jobitjoseph/Acestat-Wireless/aducm_board1.png

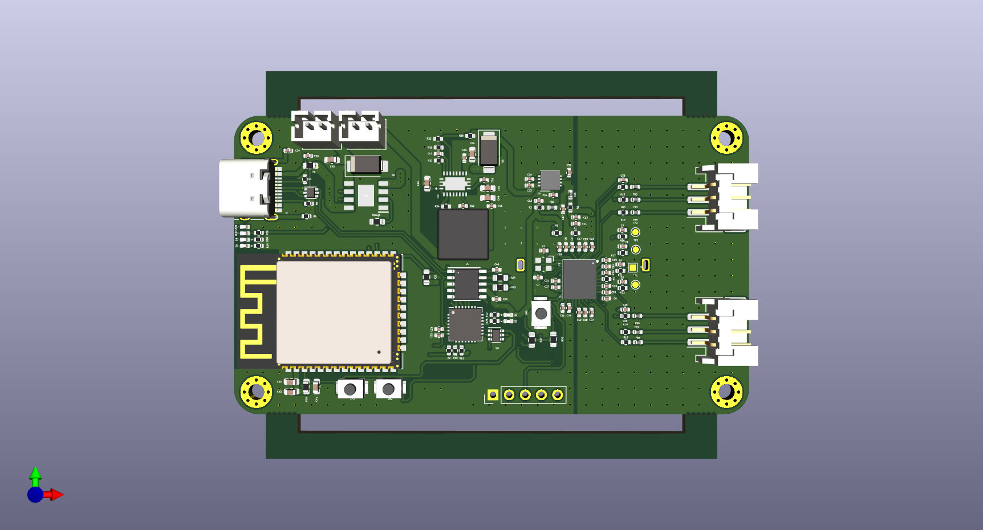
aducm_board1.png
