jobitjoseph/Acestat-Wireless/aducm_board2.png

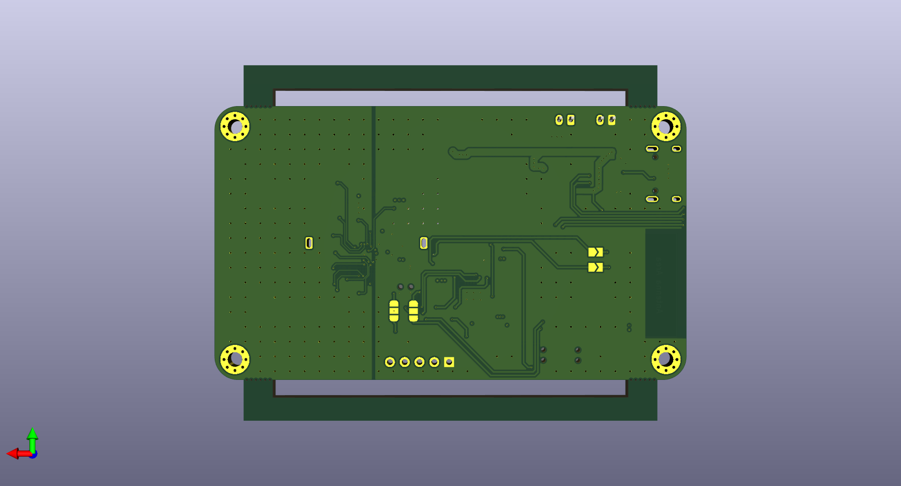
aducm_board2.png
