jobitjoseph/Acestat-Wireless/Bottom.jpg

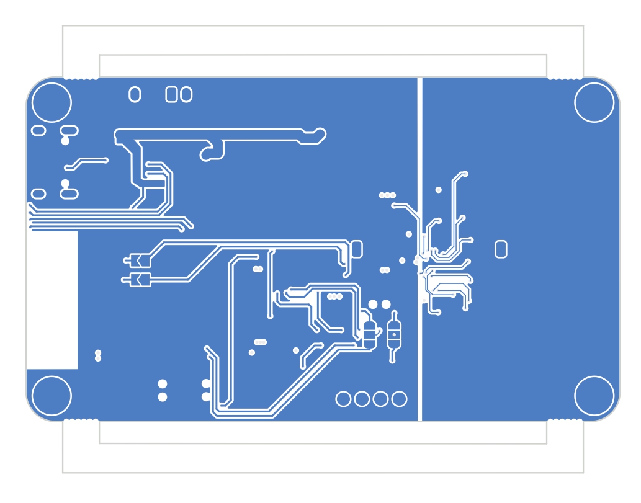
Bottom.jpg
