jobitjoseph/Acestat-Wireless/In1.jpg

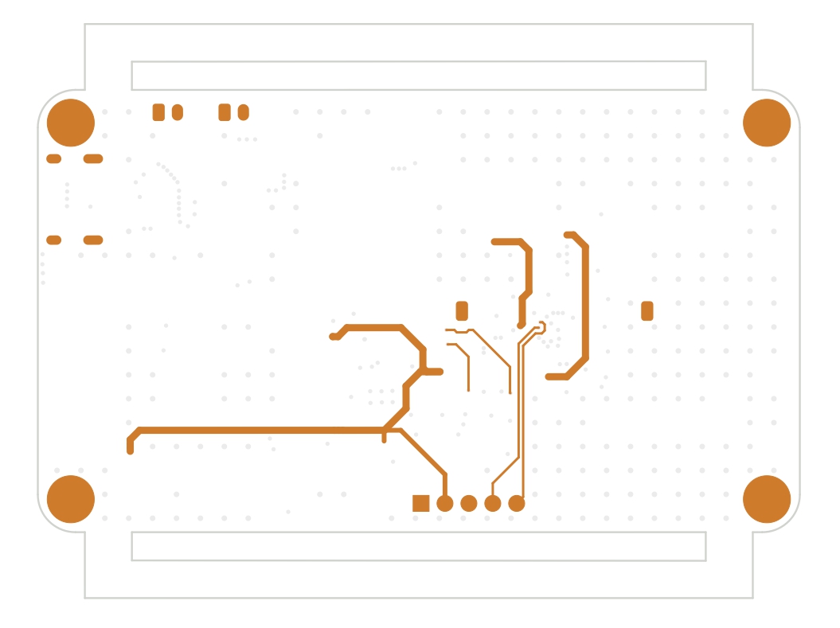
In1.jpg
