jobitjoseph/Acestat-Wireless/In2.jpg

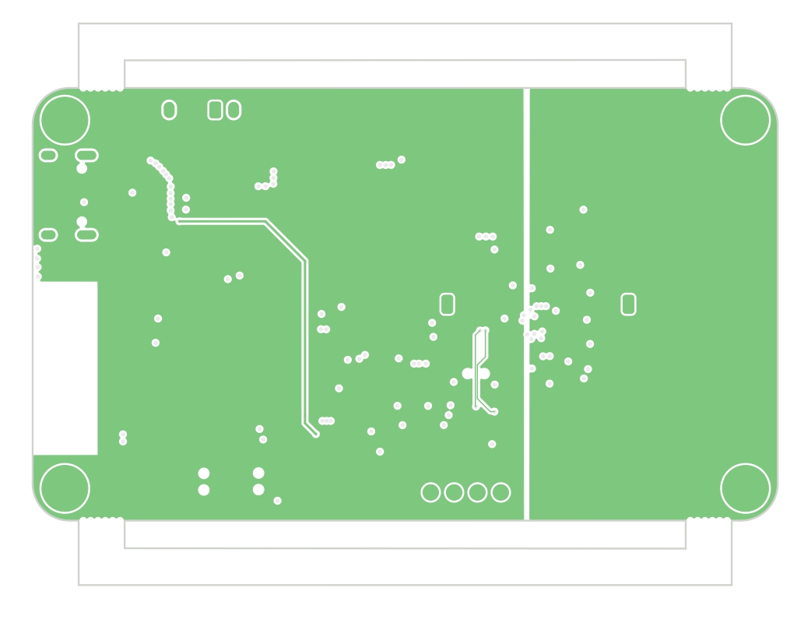
In2.jpg
