jobitjoseph/Acestat-Wireless/Top.jpg

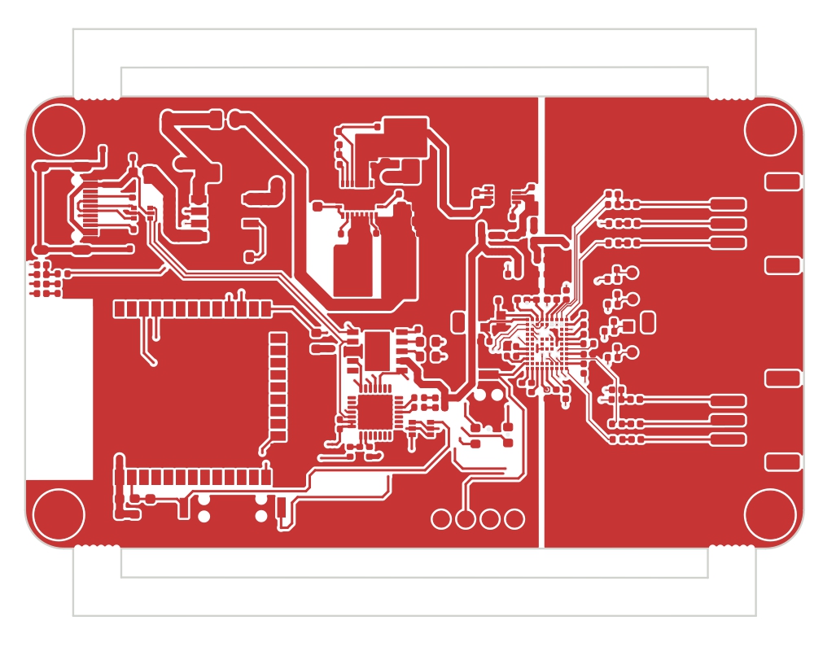
Top.jpg
