jobitjoseph/Acestat-Wireless/aducm_board.pdf

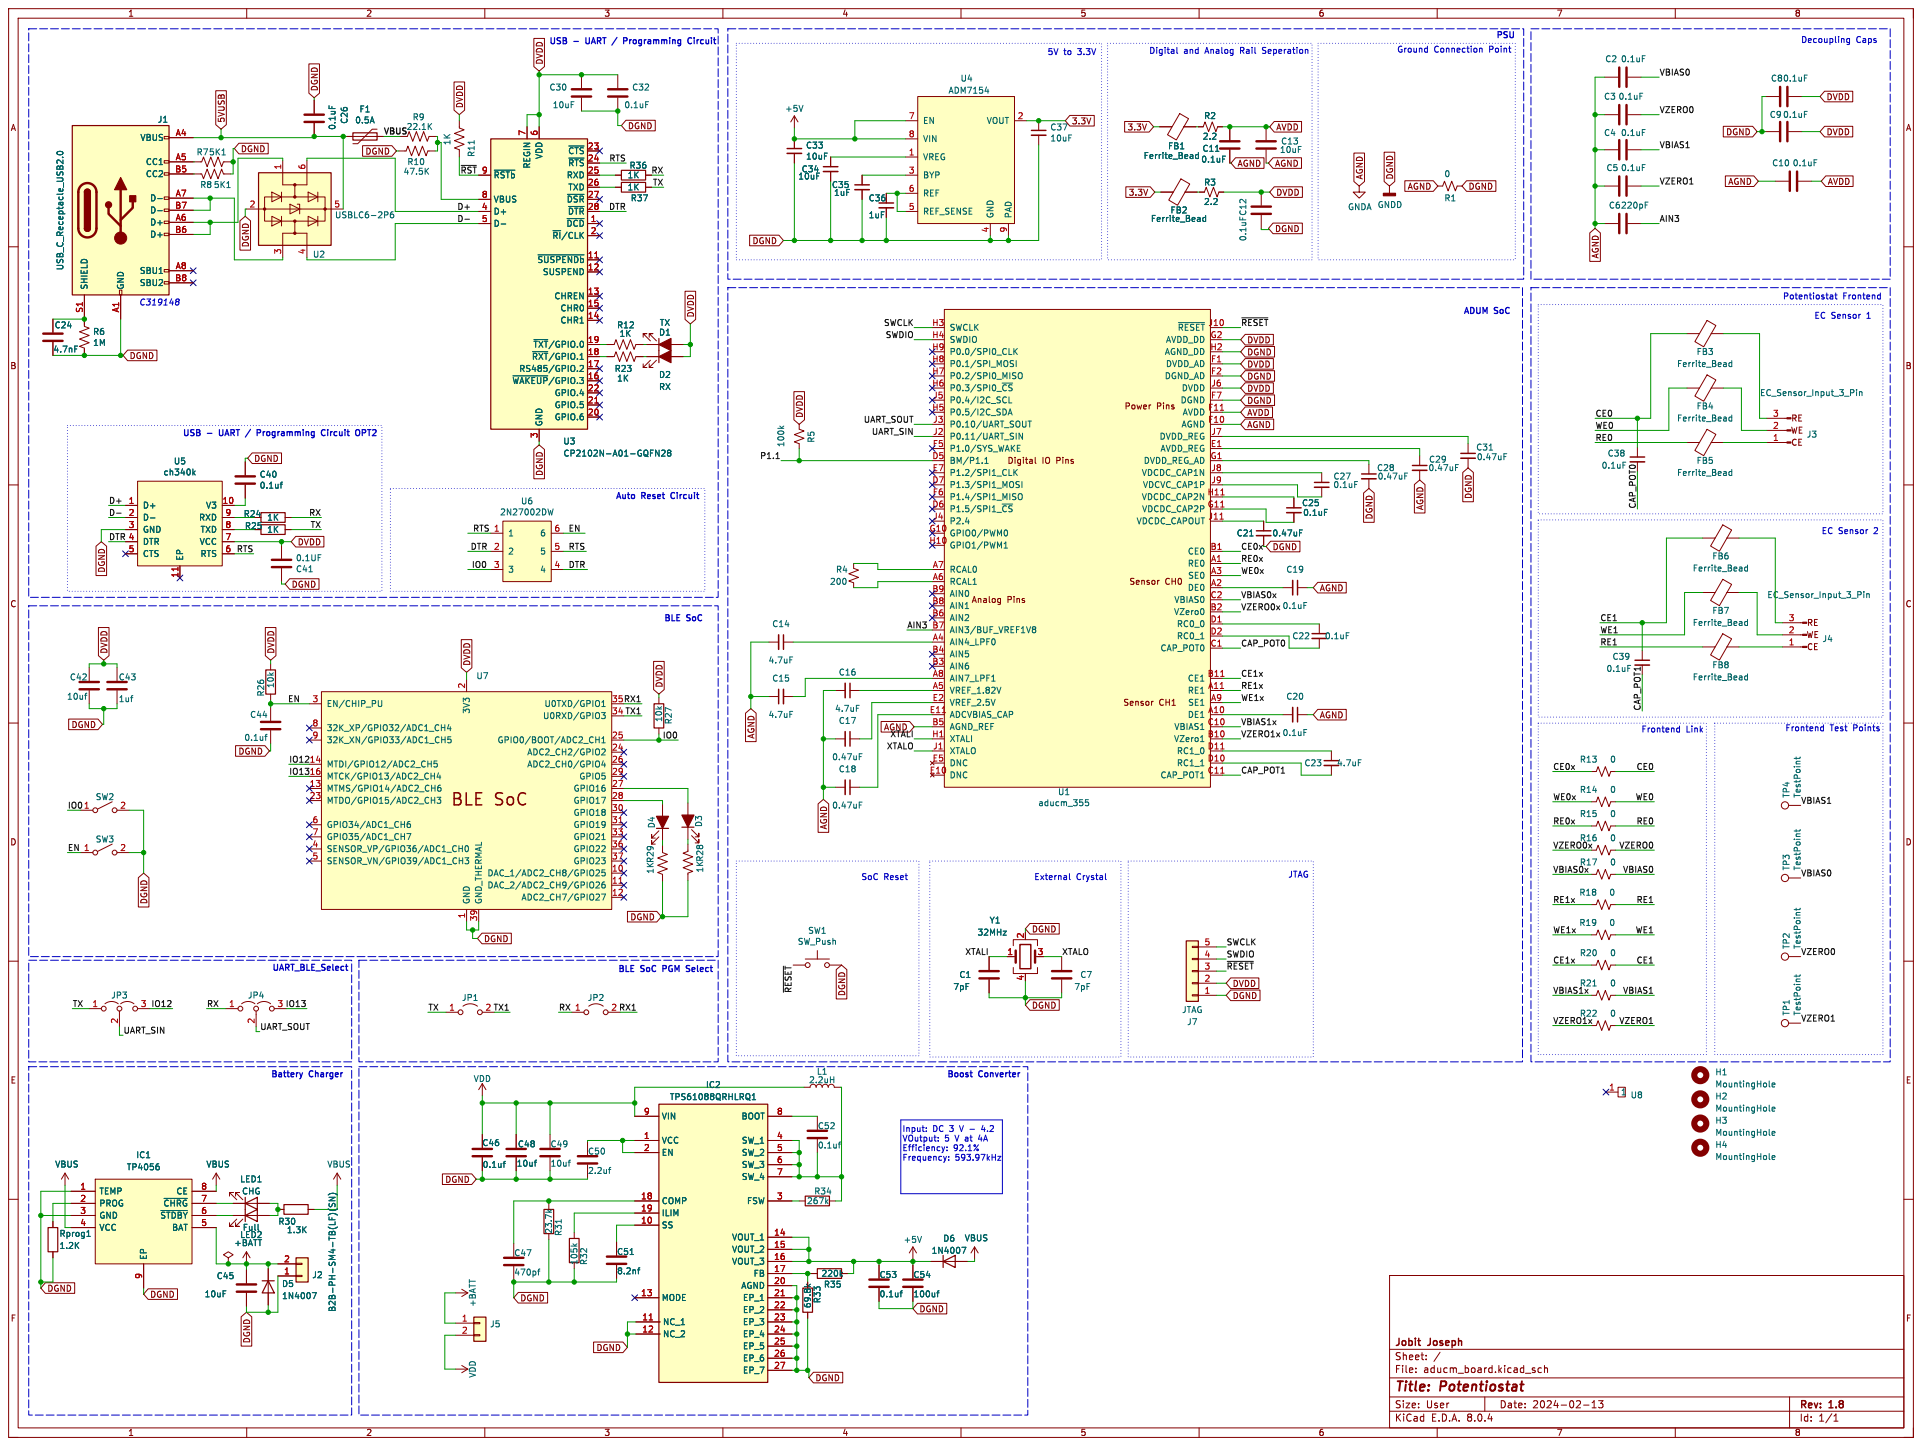
[picture p7: page 1]

4 REF_SENSE 5 REF 6 EN 7 VIN 8 PAD

Id: 1/1 Title: Potentiostat File: aducm_board.kicad_sch Sheet: / Jobit Joseph 23.7k R31 C41

H2 MountingHole H1 MountingHole H4 MountingHole H3 MountingHole

Input: DC 3 V - 4.2 VOutput: 5 V at 4A
