jobitjoseph/Acestat-Wireless/PCB/aducm_board/aducm_board.kicad_pcb

## KiCad design PCB/aducm_board/aducm_board.kicad_pcb (2024-11-03)

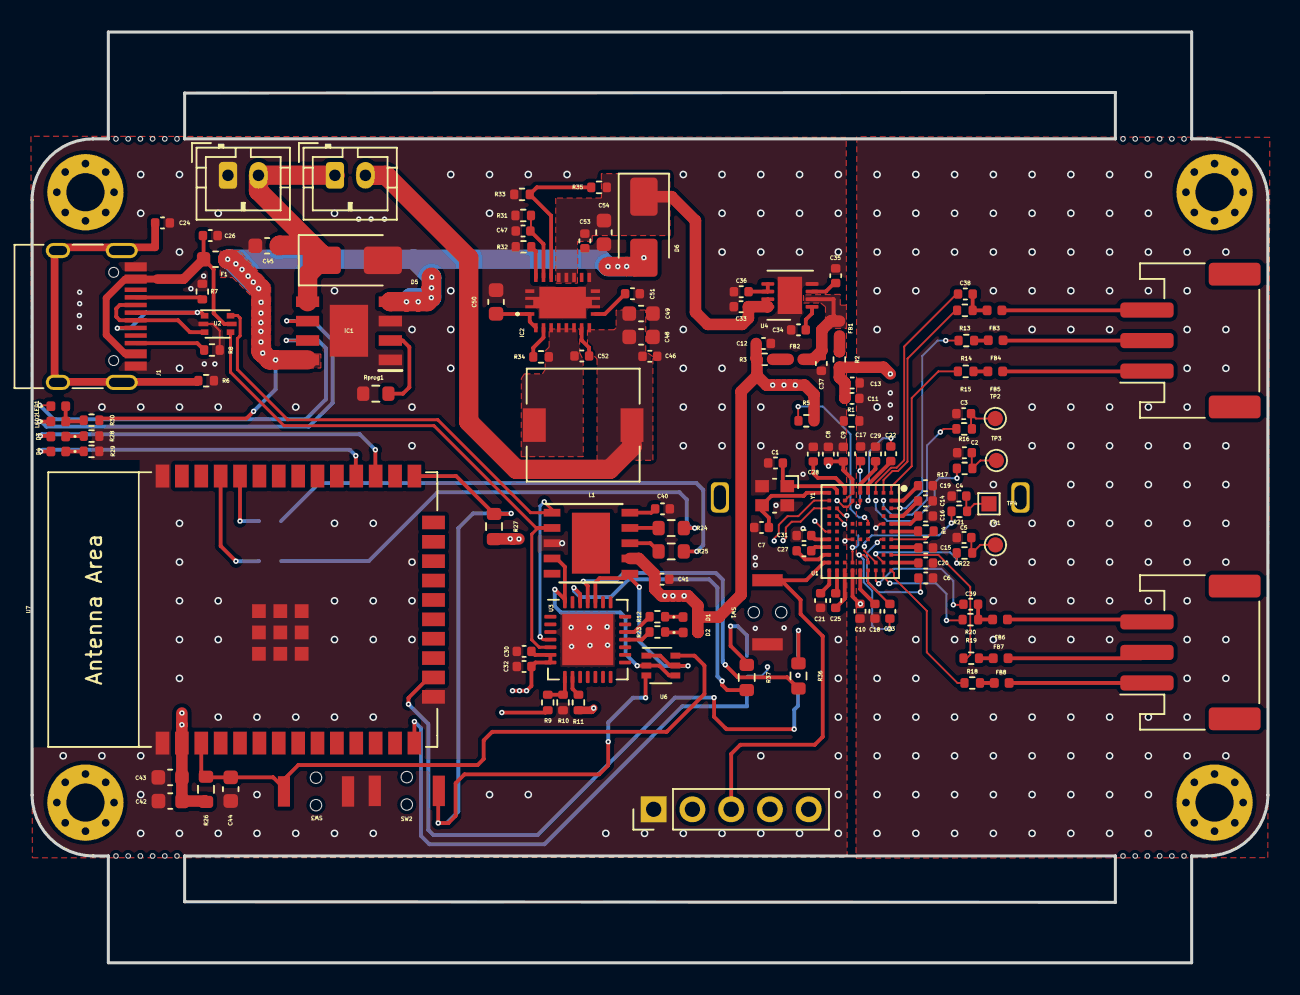
[picture p8: board aducm_board.kicad_pcb from above]

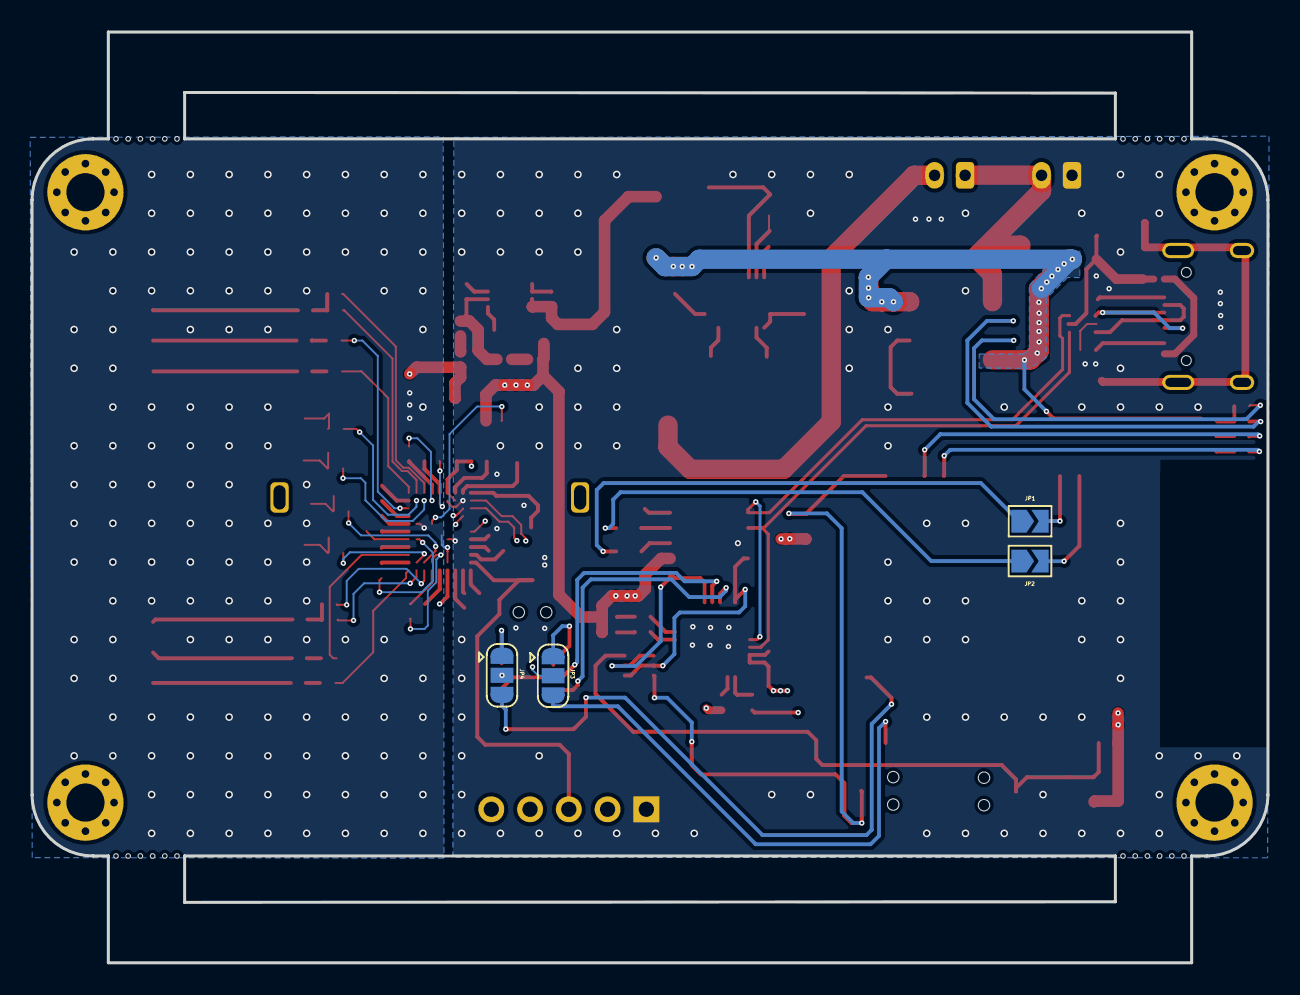
[picture p9: board aducm_board.kicad_pcb from below]

Board: 4 copper layers, 81.0 x 61.0 mm, 142 parts (4 on the bottom side), 117 nets.

Parts:
C1, C7: 7pF; C_0402_1005Metric
C2, C3, C4, C5, C8, C9, C10, C11, C12, C19, C20, C22, C25, C26, C27, C32, C38, C39: 0.1uF; C_0402_1005Metric
C6: 220pF; C_0402_1005Metric
C13, C30, C33, C34, C37: 10uF; C_0402_1005Metric
C14, C15, C16, C23: 4.7uF; C_0402_1005Metric
C17, C18, C21, C28, C29, C31: 0.47uF; C_0402_1005Metric
C24: 4.7nF; C_0402_1005Metric
C35, C36: 1uF; C_0402_1005Metric
C40, C46, C52, C53: 0.1uf; C_0402_1005Metric
C41: 0.1UF; C_0402_1005Metric
C42, C48, C49: 10uf; C_0603_1608Metric
C43: 1uf; C_0603_1608Metric
C44: 0.1uf; C_0603_1608Metric
C45: 10uF; C_0603_1608Metric
C47: 470pf; C_0402_1005Metric
C50: 2.2uf; C_0603_1608Metric
C51: 8.2nf; C_0402_1005Metric
C54: 100uf; C_0603_1608Metric
D1, D3, D4: TX; LED_0402_1005Metric
D2: RX; LED_0402_1005Metric
D5, D6: 1N4007; D_SMA
F1: 0.5A; Fuse_0603_1608Metric
FB1, FB2, FB3, FB4, FB5, FB6, FB7, FB8: Ferrite_Bead; L_0402_1005Metric
H1, H2, H3, H4: MountingHole; MountingHole_2.5mm_Pad_Via
IC1: TP4056; SOIC127P600X175-9N
IC2: TPS61088QRHLRQ1
J1: USB_C_Receptacle_USB2.0; USB_C_Receptacle_HRO_TYPE-C-31-M-12
J2, J5: B2B-PH-SM4-TB(LF)(SN); JST_PH_B2B-PH-K_1x02_P2.00mm_Vertical
J3, J4: EC_Sensor_Input_3_Pin; JST_PH_S3B-PH-SM4-TB_1x03-1MP_P2.00mm_Horizontal
J7: JTAG; PinHeader_1x05_P2.54mm_Vertical
JP1, JP2: Jumper_2_Open; SolderJumper-2_P1.3mm_Open_TrianglePad1.0x1.5mm
JP3, JP4: Jumper_3_Open; SolderJumper-3_P1.3mm_Open_RoundedPad1.0x1.5mm
L1: 2.2uH; L_7.3x7.3_H4.5
LED1, LED2: CHG; LED_0402_1005Metric
R1, R13, R14, R15, R16, R17, R18, R19, R20, R21, R22: 0; R_0402_1005Metric
R2, R3: 2.2; R_0402_1005Metric
R4: 200; R_0402_1005Metric
R5: 100k; R_0402_1005Metric
R6: 1M; R_0402_1005Metric
R7, R8: 5K1; R_0402_1005Metric
R9: 22.1K; R_0402_1005Metric
R10: 47.5K; R_0402_1005Metric
R11, R12, R23, R28, R29: 1K; R_0402_1005Metric
R24, R25, R36, R37: 1K; R_0603_1608Metric
R26, R27: 10k; R_0603_1608Metric
R30: 1.3K; R_0402_1005Metric
R31: 23.7k; R_0402_1005Metric
R32: 105k; R_0402_1005Metric
R33: 69.8k; R_0402_1005Metric
R34: 267k; R_0402_1005Metric
R35: 220k; R_0402_1005Metric
Rprog1: 1.2K; R_0603_1608Metric
SW1: SW_Push; Tactile 3x4x2mm TS-A010
SW2, SW3: TS-1088R-02526; Tactile 3x4x2mm TS-A010
TP1, TP2, TP3: TestPoint; TestPoint_Pad_D1.0mm
TP4: TestPoint; TestPoint_Pad_1.0x1.0mm
U1: aducm_355; aducm355
U2: USBLC6-2P6; SOT-666
U3: CP2102N-A01-GQFN28; QFN-28-1EP_5x5mm_P0.5mm_EP3.35x3.35mm
U4: ADM7154; LFCSP_8Lead_CP_8_21
U5: ch340k; ESSOP-10_3.9x4.9mm_P1.00mm
U6: 2N27002DW; SOT-363_SC-70-6
U7: ESP32-WROOM-E; ESP32-WROOM-32E
U8: EMI Shield
Y1: 32MHz; Crystal_SMD_Abracon_ABM10-4Pin_2.5x2.0mm

Connections:
3.3V: C37.1, FB1.2, FB2.2, U4.2 (VOUT)
5VUSB: C26.2, F1.2, J1.A4 (VBUS), J1.A9 (VBUS), J1.B4 (VBUS), J1.B9 (VBUS), U2.5 (VBUS)
+5V: C33.1, C53.1, C54.1, D6.1 (K), IC2.14 (VOUT_1), IC2.15 (VOUT_2), IC2.16 (VOUT_3), R35.1, U4.7 (EN), U4.8 (VIN)
+BATT: C45.1, D5.1 (K), IC1.5 (BAT), J2.2, J5.1
/AIN3: C6.1, U1.B7 (AIN3/BUF_VREF1V8)
/CAP_POT0: C38.2, U1.C1 (CAP_POT0)
/CAP_POT1: C39.2, U1.C11 (CAP_POT1)
/CE0: C38.1, FB3.2, R13.1
/CE0x: R13.2, U1.B1 (CE0)
/CE1: C39.1, FB6.2, R20.1
/CE1x: R20.2, U1.B11 (CE1)
/D+: U2.6 (I/O1), U3.4 (D+), U5.1 (D+)
/D-: U2.4 (I/O2), U3.5 (D-), U5.2 (D-)
/DTR: U3.28 (~DTR), U5.4 (DTR), U6.2, U6.4
/EN: C44.1, R26.1, SW3.1 (A), U6.6, U7.3 (EN/CHIP_PU)
/IO0: R27.1, SW2.1 (A), U6.3, U7.25 (GPIO0/BOOT/ADC2_CH1)
/IO12: JP3.3 (B), U7.14 (MTDI/GPIO12/ADC2_CH5)
/IO13: JP4.3 (B), U7.16 (MTCK/GPIO13/ADC2_CH4)
/P1.1: R5.1, U1.D5 (BM/P1.1)
/RE0: FB5.2, R15.1
/RE0x: R15.2, U1.A1 (RE0)
/RE1: FB8.2, R18.2
/RE1x: R18.1, U1.A11 (RE1)
/RTS: U3.24 (~RTS), U5.6 (RTS), U6.1, U6.5
/RX: JP2.1 (A), JP4.1 (A), R24.1, R36.1
/RX1: JP2.2 (B), U7.35 (U0TXD/GPIO1)
/SWCLK: J7.5, U1.H3 (SWCLK)
/SWDIO: J7.4, U1.H4 (SWDIO)
/TX: JP1.1 (A), JP3.1 (A), R25.1, R37.1
/TX1: JP1.2 (B), U7.34 (U0RXD/GPIO3)
/UART_SIN: JP3.2 (C), U1.J2 (P0.11/UART_SIN)
/UART_SOUT: JP4.2 (C), U1.J3 (P0.10/UART_SOUT)
/VBIAS0: C2.1, R17.1, TP3.1
/VBIAS0x: R17.2, U1.C2 (VBIAS0)
/VBIAS1: C4.1, R21.1, TP4.1
/VBIAS1x: R21.2, U1.C10 (VBIAS1)
/VZERO0: C3.1, R16.1, TP2.1
/VZERO0x: R16.2, U1.B2 (VZero0)
/VZERO1: C5.1, R22.1, TP1.1
/VZERO1x: R22.2, U1.B10 (VZero1)
/WE0: FB4.2, R14.1
/WE0x: R14.2, U1.A3 (SE0)
/WE1: FB7.2, R19.2
/WE1x: R19.1, U1.A9 (SE1)
/XTALI: C1.1, U1.H1 (XTALI), Y1.1
/XTALO: C7.1, U1.J1 (XTALO), Y1.3
/~RESET: J7.3, SW1.1, U1.J10 (~RESET)
/~RST: R11.2, U3.9 (~RSTb)
AGND: C2.2, C3.2, C4.2, C5.2, C6.2, C10.2, C11.2, C13.2, C14.2, C15.1, C16.2, C17.2, C18.2, C19.1, C20.1, C29.2, R1.2, U1.B5 (AGND_REF), U1.F10 (AGND)
AVDD: C10.1, C11.1, C13.1, R2.2, U1.F11 (AVDD)
DGND: C1.2, C7.2, C8.2, C9.2, C12.2, C21.2, C24.2, C26.1, C28.2, C30.2, C31.2, C32.2, C33.2, C34.2, C35.2, C36.2, C37.2, C40.1, C41.1, C42.2, C43.2, C44.2, C45.2, C46.2, C47.2, C48.2, C49.2, C50.2, C51.2, C53.2, C54.2, D5.2 (A), IC1.1 (TEMP), IC1.3 (GND), IC1.9 (EP), IC2.11 (NC_1), IC2.12 (NC_2), IC2.20 (AGND), IC2.21 (EP_1), IC2.22 (EP_2), IC2.23 (EP_3), IC2.24 (EP_4), IC2.25 (EP_5), IC2.26 (EP_6), IC2.27 (EP_7), J1.A1 (GND), J1.A12 (GND), J1.B1 (GND), J1.B12 (GND), J2.1, J7.1, R1.1, R6.2, R7.2, R8.2, R10.2, R28.1, R29.1, R31.1, R32.1, R33.2, Rprog1.2, SW1.2, SW2.2 (B), SW3.2 (B), U1.F2 (DGND_AD), U1.F7 (DGND), U1.H2 (AGND_DD), U2.2 (GND), U3.3 (GND), U3.29 (GND), U4.4 (GND), U4.9 (PAD), U5.3 (GND), U7.1 (GND), U7.15 (GND), U7.38 (GND), U7.39 (GND_THERMAL), Y1.2, Y1.4
DVDD: C8.1, C9.1, C12.1, C30.1, C32.1, C41.2, C42.1, C43.1, D1.2 (A), D2.2 (A), J7.2, R3.2, R5.2, R11.1, R26.2, R27.2, U1.F1 (DVDD_AD), U1.G2 (AVDD_DD), U1.J6 (DVDD), U3.6 (VDD), U3.7 (REGIN), U5.7 (VCC), U7.2 (3V3)
unnamed: D1.1 (K), R12.2
unnamed: D2.1 (K), R23.2
unnamed: D3.2 (A), U7.27 (GPIO16)
unnamed: D3.1 (K), R28.2
unnamed: D4.2 (A), U7.28 (GPIO17)
unnamed: D4.1 (K), R29.2
unnamed: FB1.1, R2.1
unnamed: FB2.1, R3.1
unnamed: IC1.2 (PROG), Rprog1.1
unnamed: IC1.7 (~CHRG), LED1.1 (K)
unnamed: IC1.6 (~STDBY), LED2.1 (K)
unnamed: C52.1, IC2.8 (BOOT)
unnamed: C47.1, IC2.18 (COMP), R31.2
unnamed: C50.1, IC2.1 (VCC), IC2.2 (EN)
unnamed: IC2.17 (FB), R33.1, R35.2
unnamed: IC2.3 (FSW), R34.2
unnamed: IC2.19 (ILIM), R32.2
unnamed: C51.1, IC2.10 (SS)
unnamed: C52.2, IC2.4 (SW_1), IC2.5 (SW_2), IC2.6 (SW_3), IC2.7 (SW_4), L1.2, R34.1
unnamed: J1.A5 (CC1), R7.1
unnamed: J1.B5 (CC2), R8.1
unnamed: J1.A6 (D+), J1.B6 (D+), U2.1 (I/O1)
unnamed: J1.A7 (D-), J1.B7 (D-), U2.3 (I/O2)
unnamed: C24.1, J1.S1 (SHIELD), R6.1
unnamed: FB5.1, J3.1
unnamed: FB4.1, J3.2
unnamed: FB3.1, J3.3
unnamed: FB8.1, J4.1
unnamed: FB7.1, J4.2
unnamed: FB6.1, J4.3
unnamed: LED1.2 (A), LED2.2 (A), R30.2
unnamed: C18.1, U1.E11 (ADCVBIAS_CAP)
unnamed: C14.1, U1.A4 (AIN4_LPF0)
unnamed: C15.2, U1.A8 (AIN7_LPF1)
unnamed: C29.1, U1.E1 (AVDD_REG)
unnamed: C19.2, U1.A2 (DE0)
unnamed: C20.2, U1.A10 (DE1)
unnamed: C31.1, U1.J7 (DVDD_REG)
unnamed: C28.1, U1.G1 (DVDD_REG_AD)
unnamed: C22.1, U1.D1 (RC0_0)
unnamed: C22.2, U1.D2 (RC0_1)
unnamed: C23.1, U1.D11 (RC1_0)
unnamed: C23.2, U1.D10 (RC1_1)
unnamed: R4.1, U1.A7 (RCAL0)
unnamed: R4.2, U1.A6 (RCAL1)
unnamed: C27.1, U1.J8 (VDCDC_CAP1N)
unnamed: C25.1, U1.H11 (VDCDC_CAP2N)
unnamed: C25.2, U1.G11 (VDCDC_CAP2P)
unnamed: C21.1, U1.J11 (VDCDC_CAPOUT~)
unnamed: C27.2, U1.J9 (VDCVC_CAP1P)
unnamed: C16.1, U1.A5 (VREF_1.82V)
unnamed: C17.1, U1.E2 (VREF_2.5V)
unnamed: R36.2, U3.25 (RXD)
unnamed: R37.2, U3.26 (TXD)
unnamed: R9.2, R10.1, U3.8 (VBUS)
unnamed: R23.1, U3.18 (~RXT/GPIO.1)
unnamed: R12.1, U3.19 (~TXT/GPIO.0)
unnamed: C35.1, U4.3 (BYP)
unnamed: C36.1, U4.5 (REF_SENSE), U4.6 (REF)
unnamed: C34.1, U4.1 (VREG)
unnamed: R24.2, U5.9 (RXD)
unnamed: R25.2, U5.8 (TXD)
unnamed: C40.2, U5.10 (V3)
VBUS: D6.2 (A), F1.1, IC1.4 (VCC), IC1.8 (CE), R9.1, R30.1
VDD: C46.1, C48.1, C49.1, IC2.9 (VIN), J5.2, L1.1
