jobitjoseph/Acestat-Wireless/ACEstat_Firmware/aducm355-examples/inc/ADuCM355_typedefs.h

/******************************************************************************
Copyright (c) 2017-2019 Analog Devices, Inc. All Rights Reserved.

This software is proprietary to Analog Devices, Inc. and its licensors.
By using this software you agree to the terms of the associated
Analog Devices Software License Agreement.

*****************************************************************************/

#ifndef _ADUCM355_TYPEDEFS_H
#define _ADUCM355_TYPEDEFS_H

/* pickup integer types */
#if defined(_LANGUAGE_C) || (defined(__GNUC__) && !defined(__ASSEMBLER__))
#include <stdint.h>
#endif /* _LANGUAGE_C */

#if defined ( __CC_ARM   )
#pragma push
#pragma anon_unions
#endif


#if defined (_MISRA_RULES)
/*
  anonymous unions violate ISO 9899:1990 and therefore MISRA Rule 1.1.
  Use of unions violates MISRA Rule 18.4.
  Anonymous unions are required for this implementation.
  Re-use of identifiers violates MISRA Rule 5.7.
  Field names are repeated for the ADuCM355 register map.
*/
#pragma diag(push)
#pragma diag(suppress:misra_rule_1_1:"Allow anonymous unions")
#pragma diag(suppress:misra_rule_5_1:"Allow names over 32 character limit")
#pragma diag(suppress:misra_rule_5_3:"Header will re-use typedef identifiers")
#pragma diag(suppress:misra_rule_5_6:"Header will re-use identifiers in the same scope")
#pragma diag(suppress:misra_rule_5_7:"Header will re-use identifiers")
#pragma diag(suppress:misra_rule_18_4:"Allow the use of a union")
#endif /* _MISRA_RULES */

/** @defgroup LOAD 16-bit load value (LOAD) Register
 *  16-bit load value (LOAD) Register.
 *  @{
 */

/* ==========================================================================
 *! \struct ADI_TMR_LOAD_Struct
 *! \brief  16-bit load value Register bit field structure
 * ========================================================================== */
#ifndef __ADI_NO_DECL_STRUCT_ADI_TMR_LOAD_t__
typedef struct _ADI_TMR_LOAD_t {
  union {
    struct {
      int16_t VALUE      : 16;  /**< Load value */
    };
    int16_t VALUE16;
  };
} ADI_TMR_LOAD_t;
#endif /* !__ADI_NO_DECL_STRUCT_ADI_TMR_LOAD_t__ */

/*@}*/

/** @defgroup CURCNT 16-bit timer value (CURCNT) Register
 *  16-bit timer value (CURCNT) Register.
 *  @{
 */

/* ==========================================================================
 *! \struct ADI_TMR_CURCNT_Struct
 *! \brief  16-bit timer value Register bit field structure
 * ========================================================================== */
#ifndef __ADI_NO_DECL_STRUCT_ADI_TMR_CURCNT_t__
typedef struct _ADI_TMR_CURCNT_t {
  union {
    struct {
      int16_t VALUE      : 16;  /**< Current count */
    };
    int16_t VALUE16;
  };
} ADI_TMR_CURCNT_t;
#endif /* !__ADI_NO_DECL_STRUCT_ADI_TMR_CURCNT_t__ */

/*@}*/

/** @defgroup CTL Control (CTL) Register
 *  Control (CTL) Register.
 *  @{
 */

/* ==========================================================================
 *! \struct ADI_TMR_CTL_Struct
 *! \brief  Control Register bit field structure
 * ========================================================================== */
#ifndef __ADI_NO_DECL_STRUCT_ADI_TMR_CTL_t__
typedef struct _ADI_TMR_CTL_t {
  union {
    struct {
      uint16_t PRE        :  2;  /**< Prescaler */
      uint16_t UP         :  1;  /**< Count up */
      uint16_t MODE       :  1;  /**< Timer mode */
      uint16_t EN         :  1;  /**< Timer enable */
      uint16_t CLK        :  2;  /**< Clock select */
      uint16_t RLD        :  1;  /**< Reload control */
      uint16_t EVTRANGE   :  5;  /**< Event select range */
      uint16_t EVTEN      :  1;  /**< Event select */
      uint16_t RSTEN      :  1;  /**< Counter and prescale reset enable */
      uint16_t SYNCBYP    :  1;  /**< Synchronization bypass */
    };
    uint16_t VALUE16;
  };
} ADI_TMR_CTL_t;
#endif /* !__ADI_NO_DECL_STRUCT_ADI_TMR_CTL_t__ */

/*@}*/

/** @defgroup CLRINT Clear Interrupt (CLRINT) Register
 *  Clear Interrupt (CLRINT) Register.
 *  @{
 */

/* ==========================================================================
 *! \struct ADI_TMR_CLRINT_Struct
 *! \brief  Clear Interrupt Register bit field structure
 * ========================================================================== */
#ifndef __ADI_NO_DECL_STRUCT_ADI_TMR_CLRINT_t__
typedef struct _ADI_TMR_CLRINT_t {
  union {
    struct {
      uint16_t TIMEOUT    :  1;  /**< Clear timeout interrupt */
      uint16_t EVTCAPT    :  1;  /**< Clear captured event interrupt */
      uint16_t reserved2  : 14;
    };
    uint16_t VALUE16;
  };
} ADI_TMR_CLRINT_t;
#endif /* !__ADI_NO_DECL_STRUCT_ADI_TMR_CLRINT_t__ */

/*@}*/

/** @defgroup CAPTURE Capture (CAPTURE) Register
 *  Capture (CAPTURE) Register.
 *  @{
 */

/* ==========================================================================
 *! \struct ADI_TMR_CAPTURE_Struct
 *! \brief  Capture Register bit field structure
 * ========================================================================== */
#ifndef __ADI_NO_DECL_STRUCT_ADI_TMR_CAPTURE_t__
typedef struct _ADI_TMR_CAPTURE_t {
  union {
    struct {
      int16_t VALUE      : 16;  /**< 16-bit captured value */
    };
    int16_t VALUE16;
  };
} ADI_TMR_CAPTURE_t;
#endif /* !__ADI_NO_DECL_STRUCT_ADI_TMR_CAPTURE_t__ */

/*@}*/

/** @defgroup ALOAD 16-bit load value, asynchronous (ALOAD) Register
 *  16-bit load value, asynchronous (ALOAD) Register.
 *  @{
 */

/* ==========================================================================
 *! \struct ADI_TMR_ALOAD_Struct
 *! \brief  16-bit load value, asynchronous Register bit field structure
 * ========================================================================== */
#ifndef __ADI_NO_DECL_STRUCT_ADI_TMR_ALOAD_t__
typedef struct _ADI_TMR_ALOAD_t {
  union {
    struct {
      int16_t VALUE      : 16;  /**< Load value, asynchronous */
    };
    int16_t VALUE16;
  };
} ADI_TMR_ALOAD_t;
#endif /* !__ADI_NO_DECL_STRUCT_ADI_TMR_ALOAD_t__ */

/*@}*/

/** @defgroup ACURCNT 16-bit timer value, asynchronous (ACURCNT) Register
 *  16-bit timer value, asynchronous (ACURCNT) Register.
 *  @{
 */

/* ==========================================================================
 *! \struct ADI_TMR_ACURCNT_Struct
 *! \brief  16-bit timer value, asynchronous Register bit field structure
 * ========================================================================== */
#ifndef __ADI_NO_DECL_STRUCT_ADI_TMR_ACURCNT_t__
typedef struct _ADI_TMR_ACURCNT_t {
  union {
    struct {
      int16_t VALUE      : 16;  /**< Counter value */
    };
    int16_t VALUE16;
  };
} ADI_TMR_ACURCNT_t;
#endif /* !__ADI_NO_DECL_STRUCT_ADI_TMR_ACURCNT_t__ */

/*@}*/

/** @defgroup STAT Status (STAT) Register
 *  Status (STAT) Register.
 *  @{
 */

/* ==========================================================================
 *! \struct ADI_TMR_STAT_Struct
 *! \brief  Status Register bit field structure
 * ========================================================================== */
#ifndef __ADI_NO_DECL_STRUCT_ADI_TMR_STAT_t__
typedef struct _ADI_TMR_STAT_t {
  union {
    struct {
      uint16_t TIMEOUT    :  1;  /**< Timeout event occurred */
      uint16_t CAPTURE    :  1;  /**< Capture event pending */
      uint16_t reserved2  :  4;
      uint16_t BUSY       :  1;  /**< Timer Busy */
      uint16_t PDOK       :  1;  /**< Clear Interrupt Register synchronization */
      uint16_t CNTRST     :  1;  /**< Counter reset occurring */
      uint16_t reserved9  :  7;
    };
    uint16_t VALUE16;
  };
} ADI_TMR_STAT_t;
#endif /* !__ADI_NO_DECL_STRUCT_ADI_TMR_STAT_t__ */

/*@}*/

/** @defgroup PWMCTL PWM Control Register (PWMCTL) Register
 *  PWM Control Register (PWMCTL) Register.
 *  @{
 */

/* ==========================================================================
 *! \struct ADI_TMR_PWMCTL_Struct
 *! \brief  PWM Control Register bit field structure
 * ========================================================================== */
#ifndef __ADI_NO_DECL_STRUCT_ADI_TMR_PWMCTL_t__
typedef struct _ADI_TMR_PWMCTL_t {
  union {
    struct {
      uint16_t MATCH      :  1;  /**< PWM Match enabled */
      uint16_t IDLESTATE  :  1;  /**< PWM Idle State */
      uint16_t reserved2  : 14;
    };
    uint16_t VALUE16;
  };
} ADI_TMR_PWMCTL_t;
#endif /* !__ADI_NO_DECL_STRUCT_ADI_TMR_PWMCTL_t__ */

/*@}*/

/** @defgroup PWMMATCH PWM Match Value (PWMMATCH) Register
 *  PWM Match Value (PWMMATCH) Register.
 *  @{
 */

/* ==========================================================================
 *! \struct ADI_TMR_PWMMATCH_Struct
 *! \brief  PWM Match Value Register bit field structure
 * ========================================================================== */
#ifndef __ADI_NO_DECL_STRUCT_ADI_TMR_PWMMATCH_t__
typedef struct _ADI_TMR_PWMMATCH_t {
  union {
    struct {
      int16_t VALUE      : 16;  /**< PWM Match Value */
    };
    int16_t VALUE16;
  };
} ADI_TMR_PWMMATCH_t;
#endif /* !__ADI_NO_DECL_STRUCT_ADI_TMR_PWMMATCH_t__ */

/*@}*/

/** @defgroup CR0 RTC Control 0 (CR0) Register
 *  RTC Control 0 (CR0) Register.
 *  @{
 */

/*  =========================================================================
 *! \enum   ADI_RTC_CR0_MOD60ALM
 *! \brief  Periodic, modulo-60 alarm time in prescaled RTC time units beyond a modulo-60 boundary (MOD60ALM) Enumerations
 *  ========================================================================= */
typedef enum
{
  RTC_CR0_EXAMPLE_1_THIRTY_TIME_UNITS_DECIMAL    = 30,  /**< Example of setting a modulo-60 periodic interrupt from the RTC to be issued to the CPU at 30 time units past a modulo-60 boundary. */
  RTC_CR0_EXAMPLE_2_FIFTYFIVE_TIME_UNITS_DECIMAL = 55   /**< Example of setting a modulo-60 periodic interrupt from the RTC to be issued to the CPU at 55 time units past a modulo-60 boundary. */
} ADI_RTC_CR0_MOD60ALM;


/* ==========================================================================
 *! \struct ADI_RTC_CR0_Struct
 *! \brief  RTC Control 0 Register bit field structure
 * ========================================================================== */
#ifndef __ADI_NO_DECL_STRUCT_ADI_RTC_CR0_t__
typedef struct _ADI_RTC_CR0_t {
  union {
    struct {
      uint16_t CNTEN      :  1;  /**< Global enable for the RTC */
      uint16_t ALMEN      :  1;  /**< Enable the RTC alarm (absolute) operation */
      uint16_t ALMINTEN   :  1;  /**< Enable sourced alarm interrupts to the CPU */
      uint16_t TRMEN      :  1;  /**< Enable RTC digital trimming */
      uint16_t MOD60ALMEN :  1;  /**< Enable RTC modulo-60 counting of time past a modulo-60 boundary */
      uint16_t MOD60ALM   :  6;  /**< Periodic, modulo-60 alarm time in prescaled RTC time units beyond a modulo-60 boundary */
      uint16_t MOD60ALMINTEN :  1;  /**< Enable periodic Modulo-60 RTC alarm sourced interrupts to the CPU */
      uint16_t ISOINTEN      :  1;  /**< Enable RTC power-domain isolation sourced interrupts to the CPU when isolation of the RTC power domain is activated and subsequently de-activated */
      uint16_t WPNDERRINTEN  :  1;  /**< Enable Write pending error sourced interrupts to the CPU when an RTC register-write pending error occurs */
      uint16_t WSYNCINTEN    :  1;  /**< Enable Write synchronization sourced interrupts to the CPU */
      uint16_t WPNDINTEN     :  1;  /**< Enable Write Pending sourced interrupts to the CPU */
    };
    uint16_t VALUE16;
  };
} ADI_RTC_CR0_t;
#endif /* !__ADI_NO_DECL_STRUCT_ADI_RTC_CR0_t__ */

/*@}*/

/** @defgroup SR0 RTC Status 0 (SR0) Register
 *  RTC Status 0 (SR0) Register.
 *  @{
 */

/* ==========================================================================
 *! \struct ADI_RTC_SR0_Struct
 *! \brief  RTC Status 0 Register bit field structure
 * ========================================================================== */
#ifndef __ADI_NO_DECL_STRUCT_ADI_RTC_SR0_t__
typedef struct _ADI_RTC_SR0_t {
  union {
    struct {
      uint16_t reserved0  :  1;
      uint16_t ALMINT     :  1;  /**< Alarm interrupt source */
      uint16_t MOD60ALMINT :  1;  /**< Modulo-60 RTC alarm interrupt source */
      uint16_t ISOINT      :  1;  /**< RTC power-domain isolation interrupt source */
      uint16_t WPNDERRINT  :  1;  /**< Write pending error interrupt source */
      uint16_t WSYNCINT    :  1;  /**< Write synchronization interrupt */
      uint16_t WPNDINT     :  1;  /**< Write pending interrupt */
      uint16_t WSYNCCR0    :  1;  /**< Synchronization status of posted writes to RTC Control 0 Register */
      uint16_t WSYNCSR0    :  1;  /**< Synchronization status of posted clearances to interrupt sources in RTC Status 0 Register */
      uint16_t WSYNCCNT0   :  1;  /**< Synchronization status of posted writes to RTC Count 0 Register */
      uint16_t WSYNCCNT1   :  1;  /**< Synchronization status of posted writes to RTC Count 1 Register */
      uint16_t WSYNCALM0   :  1;  /**< Synchronization status of posted writes to RTC Alarm 0 Register */
      uint16_t WSYNCALM1   :  1;  /**< Synchronization status of posted writes to RTC Alarm 1 Register */
      uint16_t WSYNCTRM    :  1;  /**< Synchronization status of posted writes to RTC Trim Register */
      uint16_t ISOENB      :  1;  /**< Visibility status of 32 kHz sourced registers, taking account of power-domain isolation */
      uint16_t reserved15  :  1;
    };
    uint16_t VALUE16;
  };
} ADI_RTC_SR0_t;
#endif /* !__ADI_NO_DECL_STRUCT_ADI_RTC_SR0_t__ */

/*@}*/

/** @defgroup SR1 RTC Status 1 (SR1) Register
 *  RTC Status 1 (SR1) Register.
 *  @{
 */

/* ==========================================================================
 *! \struct ADI_RTC_SR1_Struct
 *! \brief  RTC Status 1 Register bit field structure
 * ========================================================================== */
#ifndef __ADI_NO_DECL_STRUCT_ADI_RTC_SR1_t__
typedef struct _ADI_RTC_SR1_t {
  union {
    struct {
      uint16_t reserved0  :  7;
      uint16_t WPNDCR0    :  1;  /**< Pending status of posted writes to RTC Control 0 Register */
      uint16_t WPNDSR0    :  1;  /**< Pending status of posted clearances of interrupt sources in RTC Status 0 Register */
      uint16_t WPNDCNT0   :  1;  /**< Pending status of posted writes to RTC Count 0 Register */
      uint16_t WPNDCNT1   :  1;  /**< Pending status of posted writes to RTC Count 1 Register */
      uint16_t WPNDALM0   :  1;  /**< Pending status of posted writes to RTC ALARM 0 Register */
      uint16_t WPNDALM1   :  1;  /**< Pending status of posted writes to RTC ALARM 1 Register */
      uint16_t WPNDTRM    :  1;  /**< Pending status of posted writes to RTC Trim Register */
      uint16_t reserved14 :  2;
    };
    uint16_t VALUE16;
  };
} ADI_RTC_SR1_t;
#endif /* !__ADI_NO_DECL_STRUCT_ADI_RTC_SR1_t__ */

/*@}*/

/** @defgroup CNT0 RTC Count 0 (CNT0) Register
 *  RTC Count 0 (CNT0) Register.
 *  @{
 */

/* ==========================================================================
 *! \struct ADI_RTC_CNT0_Struct
 *! \brief  RTC Count 0 Register bit field structure
 * ========================================================================== */
#ifndef __ADI_NO_DECL_STRUCT_ADI_RTC_CNT0_t__
typedef struct _ADI_RTC_CNT0_t {
  union {
    struct {
      uint16_t VALUE      : 16;  /**< Lower 16 prescaled (non-fractional) bits of the RTC real-time count */
    };
    uint16_t VALUE16;
  };
} ADI_RTC_CNT0_t;
#endif /* !__ADI_NO_DECL_STRUCT_ADI_RTC_CNT0_t__ */

/*@}*/

/** @defgroup CNT1 RTC Count 1 (CNT1) Register
 *  RTC Count 1 (CNT1) Register.
 *  @{
 */

/* ==========================================================================
 *! \struct ADI_RTC_CNT1_Struct
 *! \brief  RTC Count 1 Register bit field structure
 * ========================================================================== */
#ifndef __ADI_NO_DECL_STRUCT_ADI_RTC_CNT1_t__
typedef struct _ADI_RTC_CNT1_t {
  union {
    struct {
      uint16_t VALUE      : 16;  /**< Upper 16 prescaled (non-fractional) bits of the RTC real-time count */
    };
    uint16_t VALUE16;
  };
} ADI_RTC_CNT1_t;
#endif /* !__ADI_NO_DECL_STRUCT_ADI_RTC_CNT1_t__ */

/*@}*/

/** @defgroup ALM0 RTC Alarm 0 (ALM0) Register
 *  RTC Alarm 0 (ALM0) Register.
 *  @{
 */

/* ==========================================================================
 *! \struct ADI_RTC_ALM0_Struct
 *! \brief  RTC Alarm 0 Register bit field structure
 * ========================================================================== */
#ifndef __ADI_NO_DECL_STRUCT_ADI_RTC_ALM0_t__
typedef struct _ADI_RTC_ALM0_t {
  union {
    struct {
      uint16_t VALUE      : 16;  /**< Lower 16 prescaled (that is, non-fractional) bits of the RTC alarm target time */
    };
    uint16_t VALUE16;
  };
} ADI_RTC_ALM0_t;
#endif /* !__ADI_NO_DECL_STRUCT_ADI_RTC_ALM0_t__ */

/*@}*/

/** @defgroup ALM1 RTC Alarm 1 (ALM1) Register
 *  RTC Alarm 1 (ALM1) Register.
 *  @{
 */

/* ==========================================================================
 *! \struct ADI_RTC_ALM1_Struct
 *! \brief  RTC Alarm 1 Register bit field structure
 * ========================================================================== */
#ifndef __ADI_NO_DECL_STRUCT_ADI_RTC_ALM1_t__
typedef struct _ADI_RTC_ALM1_t {
  union {
    struct {
      uint16_t VALUE      : 16;  /**< Upper 16 prescaled (non-fractional) bits of the RTC alarm target time */
    };
    uint16_t VALUE16;
  };
} ADI_RTC_ALM1_t;
#endif /* !__ADI_NO_DECL_STRUCT_ADI_RTC_ALM1_t__ */

/*@}*/

/** @defgroup TRM RTC Trim (TRM) Register
 *  RTC Trim (TRM) Register.
 *  @{
 */

/* ==========================================================================
 *! \struct ADI_RTC_TRM_Struct
 *! \brief  RTC Trim Register bit field structure
 * ========================================================================== */
#ifndef __ADI_NO_DECL_STRUCT_ADI_RTC_TRM_t__
typedef struct _ADI_RTC_TRM_t {
  union {
    struct {
      uint16_t VALUE      :  3;  /**< Trim value in prescaled RTC time units to be added or subtracted from the RTC count at the end of a periodic interval selected by RTC Trim Register */
      uint16_t ADD        :  1;  /**< Trim Polarity */
      uint16_t IVL        :  2;  /**< Trim interval in prescaled RTC time units */
      uint16_t IVL2EXPMIN :  4;  /**< Minimum power-of-two interval of prescaled RTC time units, which RTC Trim Register can select */
      uint16_t reserved10 :  6;
    };
    uint16_t VALUE16;
  };
} ADI_RTC_TRM_t;
#endif /* !__ADI_NO_DECL_STRUCT_ADI_RTC_TRM_t__ */

/*@}*/

/** @defgroup GWY RTC Gateway (GWY) Register
 *  RTC Gateway (GWY) Register.
 *  @{
 */

/* ==========================================================================
 *! \struct ADI_RTC_GWY_Struct
 *! \brief  RTC Gateway Register bit field structure
 * ========================================================================== */
#ifndef __ADI_NO_DECL_STRUCT_ADI_RTC_GWY_t__
typedef struct _ADI_RTC_GWY_t {
  union {
    struct {
      uint16_t SWKEY      : 16;  /**< Software-keyed command issued by the CPU */
    };
    uint16_t VALUE16;
  };
} ADI_RTC_GWY_t;
#endif /* !__ADI_NO_DECL_STRUCT_ADI_RTC_GWY_t__ */

/*@}*/

/** @defgroup CR1 RTC Control 1 (CR1) Register
 *  RTC Control 1 (CR1) Register.
 *  @{
 */

/* ==========================================================================
 *! \struct ADI_RTC_CR1_Struct
 *! \brief  RTC Control 1 Register bit field structure
 * ========================================================================== */
#ifndef __ADI_NO_DECL_STRUCT_ADI_RTC_CR1_t__
typedef struct _ADI_RTC_CR1_t {
  union {
    struct {
      uint16_t CNTINTEN   :  1;  /**< Enable for the RTC count interrupt source */
      uint16_t PSINTEN    :  1;  /**< Enable for the prescaled, modulo-1 interrupt source */
      uint16_t RTCTRMINTEN :  1;  /**< Enable for the RTC Trim interrupt source */
      uint16_t CNTROLLINTEN :  1;  /**< Enable for the RTC count roll-over interrupt source in RTC Status 2 Register */
      uint16_t CNTMOD60ROLLINTEN :  1;  /**< Enable for the RTC modulo-60 count roll-over interrupt source in RTC Status 2 Register */
      uint16_t PRESCALE2EXP      :  4;  /**< Prescale power of 2 division factor for the RTC base clock */
      uint16_t reserved9         :  7;
    };
    uint16_t VALUE16;
  };
} ADI_RTC_CR1_t;
#endif /* !__ADI_NO_DECL_STRUCT_ADI_RTC_CR1_t__ */

/*@}*/

/** @defgroup SR2 RTC Status 2 (SR2) Register
 *  RTC Status 2 (SR2) Register.
 *  @{
 */

/* ==========================================================================
 *! \struct ADI_RTC_SR2_Struct
 *! \brief  RTC Status 2 Register bit field structure
 * ========================================================================== */
#ifndef __ADI_NO_DECL_STRUCT_ADI_RTC_SR2_t__
typedef struct _ADI_RTC_SR2_t {
  union {
    struct {
      uint16_t CNTINT     :  1;  /**< RTC count interrupt source */
      uint16_t PSINT      :  1;  /**< RTC prescaled, modulo-1 boundary interrupt source */
      uint16_t TRMINT     :  1;  /**< RTC Trim interrupt source */
      uint16_t CNTROLLINT :  1;  /**< RTC count roll-over interrupt source */
      uint16_t CNTMOD60ROLLINT :  1;  /**< RTC modulo-60 count roll-over interrupt source */
      uint16_t CNTROLL         :  1;  /**< RTC count roll-over */
      uint16_t CNTMOD60ROLL    :  1;  /**< RTC count modulo-60 roll-over */
      uint16_t TRMBDYMIR       :  1;  /**< Mirror of the RTCTRMBDY field of RTC Modulo Register */
      uint16_t reserved8       :  4;
      uint16_t WPNDCR1MIR      :  1;  /**< Pending status of posted writes to RTC Control 1 Register */
      uint16_t WPNDALM2MIR     :  1;  /**< Pending status of posted writes to RTC Alarm 2 Register */
      uint16_t WSYNCCR1MIR     :  1;  /**< Synchronization status of posted writes to RTC Control 1 Register */
      uint16_t WSYNCALM2MIR    :  1;  /**< Synchronization status of posted writes to RTC Alarm 2 Register */
    };
    uint16_t VALUE16;
  };
} ADI_RTC_SR2_t;
#endif /* !__ADI_NO_DECL_STRUCT_ADI_RTC_SR2_t__ */

/*@}*/

/** @defgroup SNAP0 RTC Snapshot 0 (SNAP0) Register
 *  RTC Snapshot 0 (SNAP0) Register.
 *  @{
 */

/* ==========================================================================
 *! \struct ADI_RTC_SNAP0_Struct
 *! \brief  RTC Snapshot 0 Register bit field structure
 * ========================================================================== */
#ifndef __ADI_NO_DECL_STRUCT_ADI_RTC_SNAP0_t__
typedef struct _ADI_RTC_SNAP0_t {
  union {
    struct {
      uint16_t VALUE      : 16;  /**< Constituent part of the 47-bit RTC Input Capture Channel 0, containing a sticky snapshot of  RTC Count 0 Register */
    };
    uint16_t VALUE16;
  };
} ADI_RTC_SNAP0_t;
#endif /* !__ADI_NO_DECL_STRUCT_ADI_RTC_SNAP0_t__ */

/*@}*/

/** @defgroup SNAP1 RTC Snapshot 1 (SNAP1) Register
 *  RTC Snapshot 1 (SNAP1) Register.
 *  @{
 */

/* ==========================================================================
 *! \struct ADI_RTC_SNAP1_Struct
 *! \brief  RTC Snapshot 1 Register bit field structure
 * ========================================================================== */
#ifndef __ADI_NO_DECL_STRUCT_ADI_RTC_SNAP1_t__
typedef struct _ADI_RTC_SNAP1_t {
  union {
    struct {
      uint16_t VALUE      : 16;  /**< Constituent part of the 47-bit RTC Input Capture Channel 0, containing a sticky snapshot of  RTC Count 1 Register */
    };
    uint16_t VALUE16;
  };
} ADI_RTC_SNAP1_t;
#endif /* !__ADI_NO_DECL_STRUCT_ADI_RTC_SNAP1_t__ */

/*@}*/

/** @defgroup SNAP2 RTC Snapshot 2 (SNAP2) Register
 *  RTC Snapshot 2 (SNAP2) Register.
 *  @{
 */

/* ==========================================================================
 *! \struct ADI_RTC_SNAP2_Struct
 *! \brief  RTC Snapshot 2 Register bit field structure
 * ========================================================================== */
#ifndef __ADI_NO_DECL_STRUCT_ADI_RTC_SNAP2_t__
typedef struct _ADI_RTC_SNAP2_t {
  union {
    struct {
      uint16_t VALUE      : 15;  /**< Constituent part of the 47-bit RTC Input Capture Channel 0, containing a sticky snapshot of RTC Count 2 Register */
      uint16_t reserved15 :  1;
    };
    uint16_t VALUE16;
  };
} ADI_RTC_SNAP2_t;
#endif /* !__ADI_NO_DECL_STRUCT_ADI_RTC_SNAP2_t__ */

/*@}*/

/** @defgroup MOD RTC Modulo (MOD) Register
 *  RTC Modulo (MOD) Register.
 *  @{
 */

/* ==========================================================================
 *! \struct ADI_RTC_MOD_Struct
 *! \brief  RTC Modulo Register bit field structure
 * ========================================================================== */
#ifndef __ADI_NO_DECL_STRUCT_ADI_RTC_MOD_t__
typedef struct _ADI_RTC_MOD_t {
  union {
    struct {
      uint16_t CNTMOD60   :  6;  /**< Modulo-60 value of prescaled  RTC Count 1 and RTC Count 0 Registers */
      uint16_t INCR       :  4;  /**< Most recent increment value added to the RTC Count in RTC Count 1 and RTC Count 0 Registers */
      uint16_t TRMBDY     :  1;  /**< Trim boundary indicator that the most recent RTC count increment has coincided with trimming of the count value */
      uint16_t CNT0_4TOZERO :  5;  /**< Mirror of RTC Count 0 Register [4:0] */
    };
    uint16_t VALUE16;
  };
} ADI_RTC_MOD_t;
#endif /* !__ADI_NO_DECL_STRUCT_ADI_RTC_MOD_t__ */

/*@}*/

/** @defgroup CNT2 RTC Count 2 (CNT2) Register
 *  RTC Count 2 (CNT2) Register.
 *  @{
 */

/* ==========================================================================
 *! \struct ADI_RTC_CNT2_Struct
 *! \brief  RTC Count 2 Register bit field structure
 * ========================================================================== */
#ifndef __ADI_NO_DECL_STRUCT_ADI_RTC_CNT2_t__
typedef struct _ADI_RTC_CNT2_t {
  union {
    struct {
      uint16_t VALUE      : 15;  /**< Fractional bits of the RTC real-time count */
      uint16_t reserved15 :  1;
    };
    uint16_t VALUE16;
  };
} ADI_RTC_CNT2_t;
#endif /* !__ADI_NO_DECL_STRUCT_ADI_RTC_CNT2_t__ */

/*@}*/

/** @defgroup ALM2 RTC Alarm 2 (ALM2) Register
 *  RTC Alarm 2 (ALM2) Register.
 *  @{
 */

/* ==========================================================================
 *! \struct ADI_RTC_ALM2_Struct
 *! \brief  RTC Alarm 2 Register bit field structure
 * ========================================================================== */
#ifndef __ADI_NO_DECL_STRUCT_ADI_RTC_ALM2_t__
typedef struct _ADI_RTC_ALM2_t {
  union {
    struct {
      uint16_t VALUE      : 15;  /**< Fractional (non-prescaled) bits of the RTC alarm target time */
      uint16_t reserved15 :  1;
    };
    uint16_t VALUE16;
  };
} ADI_RTC_ALM2_t;
#endif /* !__ADI_NO_DECL_STRUCT_ADI_RTC_ALM2_t__ */

/*@}*/

/** @defgroup SR3 RTC Status 3 (SR3) Register
 *  RTC Status 3 (SR3) Register.
 *  @{
 */

/* ==========================================================================
 *! \struct ADI_RTC_SR3_Struct
 *! \brief  RTC Status 3 Register bit field structure
 * ========================================================================== */
#ifndef __ADI_NO_DECL_STRUCT_ADI_RTC_SR3_t__
typedef struct _ADI_RTC_SR3_t {
  union {
    struct {
      uint16_t RTCIC0IRQ  :  1;  /**< Sticky Interrupt Source for the RTC Input Capture Channel 0 */
      uint16_t reserved1  :  1;
      uint16_t RTCIC2IRQ  :  1;  /**< Sticky Interrupt Source for the RTC Input Capture Channel 2 */
      uint16_t RTCIC3IRQ  :  1;  /**< Sticky Interrupt Source for the RTC Input Capture Channel 3 */
      uint16_t RTCIC4IRQ  :  1;  /**< Sticky Interrupt Source for the RTC Input Capture Channel 4 */
      uint16_t reserved5  :  3;
      uint16_t ALMINTMIR  :  1;  /**< Read-only mirror of the ALMINT interrupt source in RTC Status 0 Register, acting as RTCOC0IRQ */
      uint16_t RTCOC1IRQ  :  1;  /**< Sticky Interrupt Source for Output Compare Channel 1 */
      uint16_t reserved10 :  6;
    };
    uint16_t VALUE16;
  };
} ADI_RTC_SR3_t;
#endif /* !__ADI_NO_DECL_STRUCT_ADI_RTC_SR3_t__ */

/*@}*/

/** @defgroup CR2IC RTC Control 2 for Configuring Input Capture Channels (CR2IC) Register
 *  RTC Control 2 for Configuring Input Capture Channels (CR2IC) Register.
 *  @{
 */

/* ==========================================================================
 *! \struct ADI_RTC_CR2IC_Struct
 *! \brief  RTC Control 2 for Configuring Input Capture Channels Register bit field structure
 * ========================================================================== */
#ifndef __ADI_NO_DECL_STRUCT_ADI_RTC_CR2IC_t__
typedef struct _ADI_RTC_CR2IC_t {
  union {
    struct {
      uint16_t RTCIC0EN   :  1;  /**< Enable for the RTC Input Capture Channel 0 */
      uint16_t reserved1  :  1;
      uint16_t RTCIC2EN   :  1;  /**< Enable for the RTC Input Capture Channel 2 */
      uint16_t RTCIC3EN   :  1;  /**< Enable for the RTC Input Capture Channel 3 */
      uint16_t RTCIC4EN   :  1;  /**< Enable for the RTC Input Capture Channel 4 */
      uint16_t RTCIC0LH   :  1;  /**< Polarity of the active-going capture edge for the RTC Input Capture Channel 0 */
      uint16_t reserved6  :  1;
      uint16_t RTCIC2LH   :  1;  /**< Polarity of the active-going capture edge for the RTC Input Capture Channel 2 */
      uint16_t RTCIC3LH   :  1;  /**< Polarity of the active-going capture edge for the RTC Input Capture Channel 3 */
      uint16_t RTCIC4LH   :  1;  /**< Polarity of the active-going capture edge for the RTC Input Capture Channel 4 */
      uint16_t RTCIC0IRQEN :  1;  /**< Interrupt Enable for the RTC Input Capture Channel 0 */
      uint16_t reserved11  :  1;
      uint16_t RTCIC2IRQEN :  1;  /**< Interrupt Enable for the RTC Input Capture Channel 2 */
      uint16_t RTCIC3IRQEN :  1;  /**< Interrupt Enable for the RTC Input Capture Channel 3 */
      uint16_t RTCIC4IRQEN :  1;  /**< Interrupt Enable for the RTC Input Capture Channel 4 */
      uint16_t RTCICOWUSEN :  1;  /**< Enable Overwrite of Unread Snapshots for all RTC Input Capture Channels */
    };
    uint16_t VALUE16;
  };
} ADI_RTC_CR2IC_t;
#endif /* !__ADI_NO_DECL_STRUCT_ADI_RTC_CR2IC_t__ */

/*@}*/

/** @defgroup CR3OC RTC Control 3 for Configuring Output Compare Channel (CR3OC) Register
 *  RTC Control 3 for Configuring Output Compare Channel (CR3OC) Register.
 *  @{
 */

/* ==========================================================================
 *! \struct ADI_RTC_CR3OC_Struct
 *! \brief  RTC Control 3 for Configuring Output Compare Channel Register bit field structure
 * ========================================================================== */
#ifndef __ADI_NO_DECL_STRUCT_ADI_RTC_CR3OC_t__
typedef struct _ADI_RTC_CR3OC_t {
  union {
    struct {
      uint16_t reserved0  :  1;
      uint16_t RTCOC1EN   :  1;  /**< Enable for Output Compare Channel 1 */
      uint16_t reserved2   :  7;
      uint16_t RTCOC1IRQEN :  1;  /**< Interrupt Enable for Output Compare Channel 1 */
      uint16_t reserved10  :  6;
    };
    uint16_t VALUE16;
  };
} ADI_RTC_CR3OC_t;
#endif /* !__ADI_NO_DECL_STRUCT_ADI_RTC_CR3OC_t__ */

/*@}*/

/** @defgroup CR4OC RTC Control 4 for Configuring Output Compare Channel (CR4OC) Register
 *  RTC Control 4 for Configuring Output Compare Channel (CR4OC) Register.
 *  @{
 */

/*  =========================================================================
 *! \enum   ADI_RTC_CR4OC_RTCOC1MSKEN
 *! \brief  Enable for thermometer-code masking of the Output Compare 1 Channel (RTCOC1MSKEN) Enumerations
 *  ========================================================================= */
typedef enum
{
  RTC_CR4OC_EN000 = 0,  /**< Do not apply a mask to the 16-bit Output Compare channel OC1.                                                                 */
  RTC_CR4OC_EN001 = 1   /**< Apply a thermometer-decoded mask to the 16-bit Output Compare channel OC1 provided that channel is enabled via CR3OC:RTCOC1EN */
} ADI_RTC_CR4OC_RTCOC1MSKEN;


/* ==========================================================================
 *! \struct ADI_RTC_CR4OC_Struct
 *! \brief  RTC Control 4 for Configuring Output Compare Channel Register bit field structure
 * ========================================================================== */
#ifndef __ADI_NO_DECL_STRUCT_ADI_RTC_CR4OC_t__
typedef struct _ADI_RTC_CR4OC_t {
  union {
    struct {
      uint16_t reserved0   :  1;
      uint16_t RTCOC1MSKEN :  1;  /**< Enable for thermometer-code masking of the Output Compare 1 Channel */
      uint16_t reserved2   :  7;
      uint16_t RTCOC1ARLEN :  1;  /**< Enable for auto-reloading when output compare match occurs */
      uint16_t reserved10  :  6;
    };
    uint16_t VALUE16;
  };
} ADI_RTC_CR4OC_t;
#endif /* !__ADI_NO_DECL_STRUCT_ADI_RTC_CR4OC_t__ */

/*@}*/

/** @defgroup OCMSK RTC Masks for Output Compare Channel (OCMSK) Register
 *  RTC Masks for Output Compare Channel (OCMSK) Register.
 *  @{
 */

/* ==========================================================================
 *! \struct ADI_RTC_OCMSK_Struct
 *! \brief  RTC Masks for Output Compare Channel Register bit field structure
 * ========================================================================== */
#ifndef __ADI_NO_DECL_STRUCT_ADI_RTC_OCMSK_t__
typedef struct _ADI_RTC_OCMSK_t {
  union {
    struct {
      uint16_t RTCOCMSK   : 16;  /**< Concatenation of thermometer-encoded masks for the 16-bit output compare channels */
    };
    uint16_t VALUE16;
  };
} ADI_RTC_OCMSK_t;
#endif /* !__ADI_NO_DECL_STRUCT_ADI_RTC_OCMSK_t__ */

/*@}*/

/** @defgroup OC1ARL RTC Auto-Reload for Output Compare Channel 1 (OC1ARL) Register
 *  RTC Auto-Reload for Output Compare Channel 1 (OC1ARL) Register.
 *  @{
 */

/* ==========================================================================
 *! \struct ADI_RTC_OC1ARL_Struct
 *! \brief  RTC Auto-Reload for Output Compare Channel 1 Register bit field structure
 * ========================================================================== */
#ifndef __ADI_NO_DECL_STRUCT_ADI_RTC_OC1ARL_t__
typedef struct _ADI_RTC_OC1ARL_t {
  union {
    struct {
      uint16_t RTCOC1ARL  : 16;  /**< Auto-reload value when output compare match occurs */
    };
    uint16_t VALUE16;
  };
} ADI_RTC_OC1ARL_t;
#endif /* !__ADI_NO_DECL_STRUCT_ADI_RTC_OC1ARL_t__ */

/*@}*/

/** @defgroup IC2 RTC Input Capture Channel 2 (IC2) Register
 *  RTC Input Capture Channel 2 (IC2) Register.
 *  @{
 */

/* ==========================================================================
 *! \struct ADI_RTC_IC2_Struct
 *! \brief  RTC Input Capture Channel 2 Register bit field structure
 * ========================================================================== */
#ifndef __ADI_NO_DECL_STRUCT_ADI_RTC_IC2_t__
typedef struct _ADI_RTC_IC2_t {
  union {
    struct {
      uint16_t RTCIC2     : 16;  /**< RTC Input Capture Channel 2 */
    };
    uint16_t VALUE16;
  };
} ADI_RTC_IC2_t;
#endif /* !__ADI_NO_DECL_STRUCT_ADI_RTC_IC2_t__ */

/*@}*/

/** @defgroup IC3 RTC Input Capture Channel 3 (IC3) Register
 *  RTC Input Capture Channel 3 (IC3) Register.
 *  @{
 */

/* ==========================================================================
 *! \struct ADI_RTC_IC3_Struct
 *! \brief  RTC Input Capture Channel 3 Register bit field structure
 * ========================================================================== */
#ifndef __ADI_NO_DECL_STRUCT_ADI_RTC_IC3_t__
typedef struct _ADI_RTC_IC3_t {
  union {
    struct {
      uint16_t RTCIC3     : 16;  /**< RTC Input Capture Channel 3 */
    };
    uint16_t VALUE16;
  };
} ADI_RTC_IC3_t;
#endif /* !__ADI_NO_DECL_STRUCT_ADI_RTC_IC3_t__ */

/*@}*/

/** @defgroup IC4 RTC Input Capture Channel 4 (IC4) Register
 *  RTC Input Capture Channel 4 (IC4) Register.
 *  @{
 */

/* ==========================================================================
 *! \struct ADI_RTC_IC4_Struct
 *! \brief  RTC Input Capture Channel 4 Register bit field structure
 * ========================================================================== */
#ifndef __ADI_NO_DECL_STRUCT_ADI_RTC_IC4_t__
typedef struct _ADI_RTC_IC4_t {
  union {
    struct {
      uint16_t RTCIC4     : 16;  /**< RTC Input Capture Channel 4 */
    };
    uint16_t VALUE16;
  };
} ADI_RTC_IC4_t;
#endif /* !__ADI_NO_DECL_STRUCT_ADI_RTC_IC4_t__ */

/*@}*/

/** @defgroup OC1 RTC Output Compare Channel 1 (OC1) Register
 *  RTC Output Compare Channel 1 (OC1) Register.
 *  @{
 */

/* ==========================================================================
 *! \struct ADI_RTC_OC1_Struct
 *! \brief  RTC Output Compare Channel 1 Register bit field structure
 * ========================================================================== */
#ifndef __ADI_NO_DECL_STRUCT_ADI_RTC_OC1_t__
typedef struct _ADI_RTC_OC1_t {
  union {
    struct {
      uint16_t RTCOC1     : 16;  /**< RTC Output Compare 1 Channel. Scheduled alarm target time with optional auto-reload */
    };
    uint16_t VALUE16;
  };
} ADI_RTC_OC1_t;
#endif /* !__ADI_NO_DECL_STRUCT_ADI_RTC_OC1_t__ */

/*@}*/

/** @defgroup SR4 RTC Status 4 (SR4) Register
 *  RTC Status 4 (SR4) Register.
 *  @{
 */

/* ==========================================================================
 *! \struct ADI_RTC_SR4_Struct
 *! \brief  RTC Status 4 Register bit field structure
 * ========================================================================== */
#ifndef __ADI_NO_DECL_STRUCT_ADI_RTC_SR4_t__
typedef struct _ADI_RTC_SR4_t {
  union {
    struct {
      uint16_t WSYNCSR3   :  1;  /**< Synchronization status of posted clearances to interrupt sources in RTC Status 3 Register */
      uint16_t WSYNCCR2IC :  1;  /**< Synchronization status of posted writes to RTC Control 2 for Configuring Input Capture Channels Register */
      uint16_t WSYNCCR3OC :  1;  /**< Synchronization status of posted writes to RTC Control 3 for Configuring Output Compare Channel Register */
      uint16_t WSYNCCR4OC :  1;  /**< Synchronization status of posted writes to RTC Control 4 for Configuring Output Compare Channel Register */
      uint16_t WSYNCOCMSK :  1;  /**< Synchronization status of posted writes to RTC Masks for Output Compare Channel Register */
      uint16_t WSYNCOC1ARL :  1;  /**< Synchronization status of posted writes to RTC Auto-Reload for Output Compare Channel 1 Register */
      uint16_t WSYNCOC1    :  1;  /**< Synchronization status of posted writes to RTC Output Compare Channel 1 Register */
      uint16_t reserved7   :  3;
      uint16_t RSYNCIC0    :  1;  /**< Synchronization status of posted reads of RTC Input Channel 0 */
      uint16_t reserved11  :  1;
      uint16_t RSYNCIC2    :  1;  /**< Synchronization status of posted reads of RTC Input Channel 2 */
      uint16_t RSYNCIC3    :  1;  /**< Synchronization status of posted reads of RTC Input Channel 3 */
      uint16_t RSYNCIC4    :  1;  /**< Synchronization status of posted reads of RTC Input Channel 4 */
      uint16_t reserved15  :  1;
    };
    uint16_t VALUE16;
  };
} ADI_RTC_SR4_t;
#endif /* !__ADI_NO_DECL_STRUCT_ADI_RTC_SR4_t__ */

/*@}*/

/** @defgroup SR5 RTC Status 5 (SR5) Register
 *  RTC Status 5 (SR5) Register.
 *  @{
 */

/* ==========================================================================
 *! \struct ADI_RTC_SR5_Struct
 *! \brief  RTC Status 5 Register bit field structure
 * ========================================================================== */
#ifndef __ADI_NO_DECL_STRUCT_ADI_RTC_SR5_t__
typedef struct _ADI_RTC_SR5_t {
  union {
    struct {
      uint16_t WPNDSR0    :  1;  /**< Pending status of posted clearances of interrupt sources in RTC Status 3 Register */
      uint16_t WPENDCR2IC :  1;  /**< Pending status of posted writes to RTC Control 2 for Configuring Input Capture Channels Register */
      uint16_t WPENDCR3OC :  1;  /**< Pending status of posted writes to RTC Control 3 for Configuring Output Compare Channel Register */
      uint16_t WPENDCR4OC :  1;  /**< Pending status of posted writes to RTC Control 4 for Configuring Output Compare Channel Register */
      uint16_t WPENDOCMSK :  1;  /**< Pending status of posted writes to RTC Masks for Output Compare Channel Register */
      uint16_t WPENDOC1ARL :  1;  /**< Pending status of posted writes to RTC Auto-Reload for Output Compare Channel 1 Register */
      uint16_t WPENDOC1    :  1;  /**< Pending status of posted writes to Output Compare Channel 1 */
      uint16_t reserved7   :  3;
      uint16_t RPENDIC0    :  1;  /**< Pending status of posted reads of RTC Input Channel 0 */
      uint16_t reserved11  :  1;
      uint16_t RPENDIC2    :  1;  /**< Pending status of posted reads of RTC Input Channel 2 */
      uint16_t RPENDIC3    :  1;  /**< Pending status of posted reads of RTC Input Channel 3 */
      uint16_t RPENDIC4    :  1;  /**< Pending status of posted reads of RTC Input Channel 4 */
      uint16_t reserved15  :  1;
    };
    uint16_t VALUE16;
  };
} ADI_RTC_SR5_t;
#endif /* !__ADI_NO_DECL_STRUCT_ADI_RTC_SR5_t__ */

/*@}*/

/** @defgroup SR6 RTC Status 6 (SR6) Register
 *  RTC Status 6 (SR6) Register.
 *  @{
 */

/* ==========================================================================
 *! \struct ADI_RTC_SR6_Struct
 *! \brief  RTC Status 6 Register bit field structure
 * ========================================================================== */
#ifndef __ADI_NO_DECL_STRUCT_ADI_RTC_SR6_t__
typedef struct _ADI_RTC_SR6_t {
  union {
    struct {
      uint16_t RTCIC0UNR  :  1;  /**< Sticky unread status of the RTC Input Capture Channel 0 */
      uint16_t reserved1  :  1;
      uint16_t RTCIC2UNR  :  1;  /**< Sticky unread status of the RTC Input Capture Channel 2 */
      uint16_t RTCIC3UNR  :  1;  /**< Sticky unread status of the RTC Input Capture Channel 3 */
      uint16_t RTCIC4UNR  :  1;  /**< Sticky unread status of the RTC Input Capture Channel 4 */
      uint16_t reserved5  :  3;
      uint16_t RTCIC0SNAP :  1;  /**< Confirmation that RTC Snapshot 0, 1, 2 registers reflect the value of RTC Input Capture Channel 0 */
      uint16_t RTCFRZCNTPTR :  2;  /**< Pointer for the triple-read sequence of the RTC Freeze Count MMR */
      uint16_t reserved11   :  5;
    };
    uint16_t VALUE16;
  };
} ADI_RTC_SR6_t;
#endif /* !__ADI_NO_DECL_STRUCT_ADI_RTC_SR6_t__ */

/*@}*/

/** @defgroup OC1TGT RTC Output Compare Channel 1 Target (OC1TGT) Register
 *  RTC Output Compare Channel 1 Target (OC1TGT) Register.
 *  @{
 */

/* ==========================================================================
 *! \struct ADI_RTC_OC1TGT_Struct
 *! \brief  RTC Output Compare Channel 1 Target Register bit field structure
 * ========================================================================== */
#ifndef __ADI_NO_DECL_STRUCT_ADI_RTC_OC1TGT_t__
typedef struct _ADI_RTC_OC1TGT_t {
  union {
    struct {
      uint16_t RTCOC1TGT  : 16;  /**< Current, cumulative target time for Output Compare Channel 1, taking account of any auto-reloading */
    };
    uint16_t VALUE16;
  };
} ADI_RTC_OC1TGT_t;
#endif /* !__ADI_NO_DECL_STRUCT_ADI_RTC_OC1TGT_t__ */

/*@}*/

/** @defgroup FRZCNT RTC Freeze Count (FRZCNT) Register
 *  RTC Freeze Count (FRZCNT) Register.
 *  @{
 */

/* ==========================================================================
 *! \struct ADI_RTC_FRZCNT_Struct
 *! \brief  RTC Freeze Count Register bit field structure
 * ========================================================================== */
#ifndef __ADI_NO_DECL_STRUCT_ADI_RTC_FRZCNT_t__
typedef struct _ADI_RTC_FRZCNT_t {
  union {
    struct {
      uint16_t RTCFRZCNT  : 16;  /**< RTC Freeze Count */
    };
    uint16_t VALUE16;
  };
} ADI_RTC_FRZCNT_t;
#endif /* !__ADI_NO_DECL_STRUCT_ADI_RTC_FRZCNT_t__ */

/*@}*/

/** @defgroup ADIID ADI Identification (ADIID) Register
 *  ADI Identification (ADIID) Register.
 *  @{
 */

/* ==========================================================================
 *! \struct ADI_SYS_ADIID_Struct
 *! \brief  ADI Identification Register bit field structure
 * ========================================================================== */
#ifndef __ADI_NO_DECL_STRUCT_ADI_SYS_ADIID_t__
typedef struct _ADI_SYS_ADIID_t {
  union {
    struct {
      uint16_t VALUE      : 16;  /**< Reads a fixed value of 0x4144 to indicate to debuggers that they are connected to an Analog Devices implemented Cortex based part */
    };
    uint16_t VALUE16;
  };
} ADI_SYS_ADIID_t;
#endif /* !__ADI_NO_DECL_STRUCT_ADI_SYS_ADIID_t__ */

/*@}*/

/** @defgroup CHIPID Chip Identifier (CHIPID) Register
 *  Chip Identifier (CHIPID) Register.
 *  @{
 */

/* ==========================================================================
 *! \struct ADI_SYS_CHIPID_Struct
 *! \brief  Chip Identifier Register bit field structure
 * ========================================================================== */
#ifndef __ADI_NO_DECL_STRUCT_ADI_SYS_CHIPID_t__
typedef struct _ADI_SYS_CHIPID_t {
  union {
    struct {
      uint16_t REV        :  4;  /**< Silicon revision */
      uint16_t PARTID     : 12;  /**< Part identifier */
    };
    uint16_t VALUE16;
  };
} ADI_SYS_CHIPID_t;
#endif /* !__ADI_NO_DECL_STRUCT_ADI_SYS_CHIPID_t__ */

/*@}*/

/** @defgroup SWDEN Serial Wire Debug Enable (SWDEN) Register
 *  Serial Wire Debug Enable (SWDEN) Register.
 *  @{
 */

/* ==========================================================================
 *! \struct ADI_SYS_SWDEN_Struct
 *! \brief  Serial Wire Debug Enable Register bit field structure
 * ========================================================================== */
#ifndef __ADI_NO_DECL_STRUCT_ADI_SYS_SWDEN_t__
typedef struct _ADI_SYS_SWDEN_t {
  union {
    struct {
      uint16_t VALUE      : 16;  /**< To enable SWD interface */
    };
    uint16_t VALUE16;
  };
} ADI_SYS_SWDEN_t;
#endif /* !__ADI_NO_DECL_STRUCT_ADI_SYS_SWDEN_t__ */

/*@}*/

/** @defgroup LOAD Load value (LOAD) Register
 *  Load value (LOAD) Register.
 *  @{
 */

/* ==========================================================================
 *! \struct ADI_WDT_LOAD_Struct
 *! \brief  Load value Register bit field structure
 * ========================================================================== */
#ifndef __ADI_NO_DECL_STRUCT_ADI_WDT_LOAD_t__
typedef struct _ADI_WDT_LOAD_t {
  union {
    struct {
      int16_t VALUE      : 16;  /**< Load value */
    };
    int16_t VALUE16;
  };
} ADI_WDT_LOAD_t;
#endif /* !__ADI_NO_DECL_STRUCT_ADI_WDT_LOAD_t__ */

/*@}*/

/** @defgroup CCNT Current count value (CCNT) Register
 *  Current count value (CCNT) Register.
 *  @{
 */

/* ==========================================================================
 *! \struct ADI_WDT_CCNT_Struct
 *! \brief  Current count value Register bit field structure
 * ========================================================================== */
#ifndef __ADI_NO_DECL_STRUCT_ADI_WDT_CCNT_t__
typedef struct _ADI_WDT_CCNT_t {
  union {
    struct {
      int16_t VALUE      : 16;  /**< Current count value */
    };
    int16_t VALUE16;
  };
} ADI_WDT_CCNT_t;
#endif /* !__ADI_NO_DECL_STRUCT_ADI_WDT_CCNT_t__ */

/*@}*/

/** @defgroup CTL Control (CTL) Register
 *  Control (CTL) Register.
 *  @{
 */

/*  =========================================================================
 *! \enum   ADI_WDT_CTL_PRE
 *! \brief  Prescaler (PRE) Enumerations
 *  ========================================================================= */
typedef enum
{
  WDT_CTL_DIV1     = 0,  /**< source clock/1.             */
  WDT_CTL_DIV16    = 1,  /**< source clock/16.            */
  WDT_CTL_DIV256   = 2,  /**< source clock/256 (default). */
  WDT_CTL_RESERVED = 3   /**< Reserved                    */
} ADI_WDT_CTL_PRE;


/* ==========================================================================
 *! \struct ADI_WDT_CTL_Struct
 *! \brief  Control Register bit field structure
 * ========================================================================== */
#ifndef __ADI_NO_DECL_STRUCT_ADI_WDT_CTL_t__
typedef struct _ADI_WDT_CTL_t {
  union {
    struct {
      uint16_t reserved0  :  1;
      uint16_t IRQ        :  1;  /**< Timer interrupt */
      uint16_t PRE        :  2;  /**< Prescaler */
      uint16_t reserved4  :  1;
      uint16_t EN         :  1;  /**< Timer enable */
      uint16_t MODE       :  1;  /**< Timer mode */
      uint16_t SPARE      :  1;  /**< Unused spare bit */
      uint16_t reserved8  :  8;
    };
    uint16_t VALUE16;
  };
} ADI_WDT_CTL_t;
#endif /* !__ADI_NO_DECL_STRUCT_ADI_WDT_CTL_t__ */

/*@}*/

/** @defgroup RESTART Clear interrupt (RESTART) Register
 *  Clear interrupt (RESTART) Register.
 *  @{
 */

/* ==========================================================================
 *! \struct ADI_WDT_RESTART_Struct
 *! \brief  Clear interrupt Register bit field structure
 * ========================================================================== */
#ifndef __ADI_NO_DECL_STRUCT_ADI_WDT_RESTART_t__
typedef struct _ADI_WDT_RESTART_t {
  union {
    struct {
      int16_t CLRWORD    : 16;  /**< Clear watchdog */
    };
    int16_t VALUE16;
  };
} ADI_WDT_RESTART_t;
#endif /* !__ADI_NO_DECL_STRUCT_ADI_WDT_RESTART_t__ */

/*@}*/

/** @defgroup STAT Status (STAT) Register
 *  Status (STAT) Register.
 *  @{
 */

/* ==========================================================================
 *! \struct ADI_WDT_STAT_Struct
 *! \brief  Status Register bit field structure
 * ========================================================================== */
#ifndef __ADI_NO_DECL_STRUCT_ADI_WDT_STAT_t__
typedef struct _ADI_WDT_STAT_t {
  union {
    struct {
      uint16_t IRQ        :  1;  /**< WDT Interrupt */
      uint16_t CLRIRQ     :  1;  /**< Clear Interrupt Register write sync in progress */
      uint16_t LOADING    :  1;  /**< Load Register write sync in progress */
      uint16_t COUNTING   :  1;  /**< Control Register write sync in progress */
      uint16_t LOCKED     :  1;  /**< Lock status bit */
      uint16_t RSTCTL     :  1;  /**< Reset Control Register written and locked */
      uint16_t reserved6  : 10;
    };
    uint16_t VALUE16;
  };
} ADI_WDT_STAT_t;
#endif /* !__ADI_NO_DECL_STRUCT_ADI_WDT_STAT_t__ */

/*@}*/

/** @defgroup MCTL Master control (MCTL) Register
 *  Master control (MCTL) Register.
 *  @{
 */

/* ==========================================================================
 *! \struct ADI_I2C_MCTL_Struct
 *! \brief  Master control Register bit field structure
 * ========================================================================== */
#ifndef __ADI_NO_DECL_STRUCT_ADI_I2C_MCTL_t__
typedef struct _ADI_I2C_MCTL_t {
  union {
    struct {
      uint16_t MASEN      :  1;  /**< Master enable */
      uint16_t COMPLETE   :  1;  /**< Start back-off disable */
      uint16_t LOOPBACK   :  1;  /**< Internal loopback enable */
      uint16_t STRETCHSCL :  1;  /**< Stretch SCL enable */
      uint16_t IENMRX     :  1;  /**< Receive request interrupt enable */
      uint16_t IENMTX     :  1;  /**< Transmit request interrupt enable. */
      uint16_t IENALOST   :  1;  /**< Arbitration lost interrupt enable */
      uint16_t IENACK     :  1;  /**< ACK not received interrupt enable */
      uint16_t IENCMP     :  1;  /**< Transaction completed (or stop detected) interrupt enable */
      uint16_t MXMITDEC   :  1;  /**< Decrement master TX FIFO status when a byte has been transmitted */
      uint16_t MRXDMA     :  1;  /**< Enable master Rx DMA request */
      uint16_t MTXDMA     :  1;  /**< Enable master Tx DMA request */
      uint16_t BUSCLR     :  1;  /**< Bus-Clear Enable */
      uint16_t STOPBUSCLR :  1;  /**< Prestop Bus-Clear */
      uint16_t reserved14 :  2;
    };
    uint16_t VALUE16;
  };
} ADI_I2C_MCTL_t;
#endif /* !__ADI_NO_DECL_STRUCT_ADI_I2C_MCTL_t__ */

/*@}*/

/** @defgroup MSTAT Master status (MSTAT) Register
 *  Master status (MSTAT) Register.
 *  @{
 */

/* ==========================================================================
 *! \struct ADI_I2C_MSTAT_Struct
 *! \brief  Master status Register bit field structure
 * ========================================================================== */
#ifndef __ADI_NO_DECL_STRUCT_ADI_I2C_MSTAT_t__
typedef struct _ADI_I2C_MSTAT_t {
  union {
    struct {
      uint16_t MTXF       :  2;  /**< Master Transmit FIFO status */
      uint16_t MTXREQ     :  1;  /**< When read is master Transmit request; when write is Clear master transmit interrupt bit */
      uint16_t MRXREQ     :  1;  /**< Master Receive request */
      uint16_t NACKADDR   :  1;  /**< ACK not received in response to an address */
      uint16_t ALOST      :  1;  /**< Arbitration lost */
      uint16_t MBUSY      :  1;  /**< Master busy */
      uint16_t NACKDATA   :  1;  /**< ACK not received in response to data write */
      uint16_t TCOMP      :  1;  /**< Transaction complete or stop detected */
      uint16_t MRXOVR     :  1;  /**< Master Receive FIFO overflow */
      uint16_t LINEBUSY   :  1;  /**< Line is busy */
      uint16_t MSTOP      :  1;  /**< STOP driven by this I2C Master */
      uint16_t MTXUNDR    :  1;  /**< Master Transmit Underflow */
      uint16_t SDAFILT    :  1;  /**< State of SDA Line */
      uint16_t SCLFILT    :  1;  /**< State of SCL Line */
      uint16_t reserved15 :  1;
    };
    uint16_t VALUE16;
  };
} ADI_I2C_MSTAT_t;
#endif /* !__ADI_NO_DECL_STRUCT_ADI_I2C_MSTAT_t__ */

/*@}*/

/** @defgroup MRX Master receive data (MRX) Register
 *  Master receive data (MRX) Register.
 *  @{
 */

/* ==========================================================================
 *! \struct ADI_I2C_MRX_Struct
 *! \brief  Master receive data Register bit field structure
 * ========================================================================== */
#ifndef __ADI_NO_DECL_STRUCT_ADI_I2C_MRX_t__
typedef struct _ADI_I2C_MRX_t {
  union {
    struct {
      uint16_t VALUE      :  8;  /**< Master receive register */
      uint16_t reserved8  :  8;
    };
    uint16_t VALUE16;
  };
} ADI_I2C_MRX_t;
#endif /* !__ADI_NO_DECL_STRUCT_ADI_I2C_MRX_t__ */

/*@}*/

/** @defgroup MTX Master transmit data (MTX) Register
 *  Master transmit data (MTX) Register.
 *  @{
 */

/* ==========================================================================
 *! \struct ADI_I2C_MTX_Struct
 *! \brief  Master transmit data Register bit field structure
 * ========================================================================== */
#ifndef __ADI_NO_DECL_STRUCT_ADI_I2C_MTX_t__
typedef struct _ADI_I2C_MTX_t {
  union {
    struct {
      uint16_t VALUE      :  8;  /**< Master transmit register */
      uint16_t reserved8  :  8;
    };
    uint16_t VALUE16;
  };
} ADI_I2C_MTX_t;
#endif /* !__ADI_NO_DECL_STRUCT_ADI_I2C_MTX_t__ */

/*@}*/

/** @defgroup MRXCNT Master receive data count (MRXCNT) Register
 *  Master receive data count (MRXCNT) Register.
 *  @{
 */

/* ==========================================================================
 *! \struct ADI_I2C_MRXCNT_Struct
 *! \brief  Master receive data count Register bit field structure
 * ========================================================================== */
#ifndef __ADI_NO_DECL_STRUCT_ADI_I2C_MRXCNT_t__
typedef struct _ADI_I2C_MRXCNT_t {
  union {
    struct {
      uint16_t VALUE      :  8;  /**< Receive count */
      uint16_t EXTEND     :  1;  /**< Extended read */
      uint16_t reserved9  :  7;
    };
    uint16_t VALUE16;
  };
} ADI_I2C_MRXCNT_t;
#endif /* !__ADI_NO_DECL_STRUCT_ADI_I2C_MRXCNT_t__ */

/*@}*/

/** @defgroup MCRXCNT Master current receive data count (MCRXCNT) Register
 *  Master current receive data count (MCRXCNT) Register.
 *  @{
 */

/* ==========================================================================
 *! \struct ADI_I2C_MCRXCNT_Struct
 *! \brief  Master current receive data count Register bit field structure
 * ========================================================================== */
#ifndef __ADI_NO_DECL_STRUCT_ADI_I2C_MCRXCNT_t__
typedef struct _ADI_I2C_MCRXCNT_t {
  union {
    struct {
      uint16_t VALUE      :  8;  /**< Current receive count */
      uint16_t reserved8  :  8;
    };
    uint16_t VALUE16;
  };
} ADI_I2C_MCRXCNT_t;
#endif /* !__ADI_NO_DECL_STRUCT_ADI_I2C_MCRXCNT_t__ */

/*@}*/

/** @defgroup ADDR1 1st master address byte (ADDR1) Register
 *  1st master address byte (ADDR1) Register.
 *  @{
 */

/* ==========================================================================
 *! \struct ADI_I2C_ADDR1_Struct
 *! \brief  1st master address byte Register bit field structure
 * ========================================================================== */
#ifndef __ADI_NO_DECL_STRUCT_ADI_I2C_ADDR1_t__
typedef struct _ADI_I2C_ADDR1_t {
  union {
    struct {
      uint16_t VALUE      :  8;  /**< Address byte 1 */
      uint16_t reserved8  :  8;
    };
    uint16_t VALUE16;
  };
} ADI_I2C_ADDR1_t;
#endif /* !__ADI_NO_DECL_STRUCT_ADI_I2C_ADDR1_t__ */

/*@}*/

/** @defgroup ADDR2 2nd master address byte (ADDR2) Register
 *  2nd master address byte (ADDR2) Register.
 *  @{
 */

/* ==========================================================================
 *! \struct ADI_I2C_ADDR2_Struct
 *! \brief  2nd master address byte Register bit field structure
 * ========================================================================== */
#ifndef __ADI_NO_DECL_STRUCT_ADI_I2C_ADDR2_t__
typedef struct _ADI_I2C_ADDR2_t {
  union {
    struct {
      uint16_t VALUE      :  8;  /**< Address byte 2 */
      uint16_t reserved8  :  8;
    };
    uint16_t VALUE16;
  };
} ADI_I2C_ADDR2_t;
#endif /* !__ADI_NO_DECL_STRUCT_ADI_I2C_ADDR2_t__ */

/*@}*/

/** @defgroup BYT Start byte (BYT) Register
 *  Start byte (BYT) Register.
 *  @{
 */

/* ==========================================================================
 *! \struct ADI_I2C_BYT_Struct
 *! \brief  Start byte Register bit field structure
 * ========================================================================== */
#ifndef __ADI_NO_DECL_STRUCT_ADI_I2C_BYT_t__
typedef struct _ADI_I2C_BYT_t {
  union {
    struct {
      uint16_t SBYTE      :  8;  /**< Start byte */
      uint16_t reserved8  :  8;
    };
    uint16_t VALUE16;
  };
} ADI_I2C_BYT_t;
#endif /* !__ADI_NO_DECL_STRUCT_ADI_I2C_BYT_t__ */

/*@}*/

/** @defgroup DIV Serial clock period divisor (DIV) Register
 *  Serial clock period divisor (DIV) Register.
 *  @{
 */

/* ==========================================================================
 *! \struct ADI_I2C_DIV_Struct
 *! \brief  Serial clock period divisor Register bit field structure
 * ========================================================================== */
#ifndef __ADI_NO_DECL_STRUCT_ADI_I2C_DIV_t__
typedef struct _ADI_I2C_DIV_t {
  union {
    struct {
      uint16_t LOW        :  8;  /**< Serial clock low time */
      uint16_t HIGH       :  8;  /**< Serial clock high time */
    };
    uint16_t VALUE16;
  };
} ADI_I2C_DIV_t;
#endif /* !__ADI_NO_DECL_STRUCT_ADI_I2C_DIV_t__ */

/*@}*/

/** @defgroup SCTL Slave control (SCTL) Register
 *  Slave control (SCTL) Register.
 *  @{
 */

/* ==========================================================================
 *! \struct ADI_I2C_SCTL_Struct
 *! \brief  Slave control Register bit field structure
 * ========================================================================== */
#ifndef __ADI_NO_DECL_STRUCT_ADI_I2C_SCTL_t__
typedef struct _ADI_I2C_SCTL_t {
  union {
    struct {
      uint16_t SLVEN      :  1;  /**< Slave enable */
      uint16_t ADR10EN    :  1;  /**< Enabled 10-bit addressing */
      uint16_t GCEN       :  1;  /**< General call enable */
      uint16_t HGCEN      :  1;  /**< Hardware general call enable */
      uint16_t GCSBCLR    :  1;  /**< General call status bit clear */
      uint16_t EARLYTXR   :  1;  /**< Early transmit request mode */
      uint16_t reserved6  :  1;
      uint16_t NACK       :  1;  /**< NACK next communication */
      uint16_t IENSTOP    :  1;  /**< Stop condition detected interrupt enable */
      uint16_t IENSRX     :  1;  /**< Slave Receive request interrupt enable */
      uint16_t IENSTX     :  1;  /**< Slave Transmit request interrupt enable */
      uint16_t STXDEC     :  1;  /**< Decrement Slave Tx FIFO status when a byte has been transmitted */
      uint16_t IENREPST   :  1;  /**< Repeated start interrupt enable */
      uint16_t SRXDMA     :  1;  /**< Enable slave Rx DMA request */
      uint16_t STXDMA     :  1;  /**< Enable slave Tx DMA request */
      uint16_t reserved15 :  1;
    };
    uint16_t VALUE16;
  };
} ADI_I2C_SCTL_t;
#endif /* !__ADI_NO_DECL_STRUCT_ADI_I2C_SCTL_t__ */

/*@}*/

/** @defgroup SSTAT Slave I2C Status/Error/IRQ (SSTAT) Register
 *  Slave I2C Status/Error/IRQ (SSTAT) Register.
 *  @{
 */

/* ==========================================================================
 *! \struct ADI_I2C_SSTAT_Struct
 *! \brief  Slave I2C Status/Error/IRQ Register bit field structure
 * ========================================================================== */
#ifndef __ADI_NO_DECL_STRUCT_ADI_I2C_SSTAT_t__
typedef struct _ADI_I2C_SSTAT_t {
  union {
    struct {
      uint16_t STXFSEREQ  :  1;  /**< Slave Tx FIFO Status or early request */
      uint16_t STXUNDR    :  1;  /**< Slave Transmit FIFO underflow */
      uint16_t STXREQ     :  1;  /**< When read is slave transmit request; when write is clear slave transmit interrupt bit */
      uint16_t SRXREQ     :  1;  /**< Slave Receive request */
      uint16_t SRXOVR     :  1;  /**< Slave Receive FIFO overflow */
      uint16_t NOACK      :  1;  /**< Ack not generated by the slave */
      uint16_t SBUSY      :  1;  /**< Slave busy */
      uint16_t GCINT      :  1;  /**< General call interrupt */
      uint16_t GCID       :  2;  /**< General ID */
      uint16_t STOP       :  1;  /**< Stop after start and matching address */
      uint16_t IDMAT      :  2;  /**< Device ID matched */
      uint16_t REPSTART   :  1;  /**< Repeated start and matching address */
      uint16_t START      :  1;  /**< Start and matching address */
      uint16_t reserved15 :  1;
    };
    uint16_t VALUE16;
  };
} ADI_I2C_SSTAT_t;
#endif /* !__ADI_NO_DECL_STRUCT_ADI_I2C_SSTAT_t__ */

/*@}*/

/** @defgroup SRX Slave receive (SRX) Register
 *  Slave receive (SRX) Register.
 *  @{
 */

/* ==========================================================================
 *! \struct ADI_I2C_SRX_Struct
 *! \brief  Slave receive Register bit field structure
 * ========================================================================== */
#ifndef __ADI_NO_DECL_STRUCT_ADI_I2C_SRX_t__
typedef struct _ADI_I2C_SRX_t {
  union {
    struct {
      uint16_t VALUE      :  8;  /**< Slave receive register */
      uint16_t reserved8  :  8;
    };
    uint16_t VALUE16;
  };
} ADI_I2C_SRX_t;
#endif /* !__ADI_NO_DECL_STRUCT_ADI_I2C_SRX_t__ */

/*@}*/

/** @defgroup STX Slave transmit (STX) Register
 *  Slave transmit (STX) Register.
 *  @{
 */

/* ==========================================================================
 *! \struct ADI_I2C_STX_Struct
 *! \brief  Slave transmit Register bit field structure
 * ========================================================================== */
#ifndef __ADI_NO_DECL_STRUCT_ADI_I2C_STX_t__
typedef struct _ADI_I2C_STX_t {
  union {
    struct {
      uint16_t VALUE      :  8;  /**< Slave transmit register */
      uint16_t reserved8  :  8;
    };
    uint16_t VALUE16;
  };
} ADI_I2C_STX_t;
#endif /* !__ADI_NO_DECL_STRUCT_ADI_I2C_STX_t__ */

/*@}*/

/** @defgroup ALT Hardware general call ID (ALT) Register
 *  Hardware general call ID (ALT) Register.
 *  @{
 */

/* ==========================================================================
 *! \struct ADI_I2C_ALT_Struct
 *! \brief  Hardware general call ID Register bit field structure
 * ========================================================================== */
#ifndef __ADI_NO_DECL_STRUCT_ADI_I2C_ALT_t__
typedef struct _ADI_I2C_ALT_t {
  union {
    struct {
      uint16_t ID         :  8;  /**< Slave Alt */
      uint16_t reserved8  :  8;
    };
    uint16_t VALUE16;
  };
} ADI_I2C_ALT_t;
#endif /* !__ADI_NO_DECL_STRUCT_ADI_I2C_ALT_t__ */

/*@}*/

/** @defgroup ID0 1st slave address device ID (ID0) Register
 *  1st slave address device ID (ID0) Register.
 *  @{
 */

/* ==========================================================================
 *! \struct ADI_I2C_ID0_Struct
 *! \brief  1st slave address device ID Register bit field structure
 * ========================================================================== */
#ifndef __ADI_NO_DECL_STRUCT_ADI_I2C_ID0_t__
typedef struct _ADI_I2C_ID0_t {
  union {
    struct {
      uint16_t VALUE      :  8;  /**< Slave device ID 0 */
      uint16_t reserved8  :  8;
    };
    uint16_t VALUE16;
  };
} ADI_I2C_ID0_t;
#endif /* !__ADI_NO_DECL_STRUCT_ADI_I2C_ID0_t__ */

/*@}*/

/** @defgroup ID1 2nd slave address device ID (ID1) Register
 *  2nd slave address device ID (ID1) Register.
 *  @{
 */

/* ==========================================================================
 *! \struct ADI_I2C_ID1_Struct
 *! \brief  2nd slave address device ID Register bit field structure
 * ========================================================================== */
#ifndef __ADI_NO_DECL_STRUCT_ADI_I2C_ID1_t__
typedef struct _ADI_I2C_ID1_t {
  union {
    struct {
      uint16_t VALUE      :  8;  /**< Slave device ID 1 */
      uint16_t reserved8  :  8;
    };
    uint16_t VALUE16;
  };
} ADI_I2C_ID1_t;
#endif /* !__ADI_NO_DECL_STRUCT_ADI_I2C_ID1_t__ */

/*@}*/

/** @defgroup ID2 3rd slave address device ID (ID2) Register
 *  3rd slave address device ID (ID2) Register.
 *  @{
 */

/* ==========================================================================
 *! \struct ADI_I2C_ID2_Struct
 *! \brief  3rd slave address device ID Register bit field structure
 * ========================================================================== */
#ifndef __ADI_NO_DECL_STRUCT_ADI_I2C_ID2_t__
typedef struct _ADI_I2C_ID2_t {
  union {
    struct {
      uint16_t VALUE      :  8;  /**< Slave device ID 2 */
      uint16_t reserved8  :  8;
    };
    uint16_t VALUE16;
  };
} ADI_I2C_ID2_t;
#endif /* !__ADI_NO_DECL_STRUCT_ADI_I2C_ID2_t__ */

/*@}*/

/** @defgroup ID3 4th slave address device ID (ID3) Register
 *  4th slave address device ID (ID3) Register.
 *  @{
 */

/* ==========================================================================
 *! \struct ADI_I2C_ID3_Struct
 *! \brief  4th slave address device ID Register bit field structure
 * ========================================================================== */
#ifndef __ADI_NO_DECL_STRUCT_ADI_I2C_ID3_t__
typedef struct _ADI_I2C_ID3_t {
  union {
    struct {
      uint16_t VALUE      :  8;  /**< Slave device ID 3 */
      uint16_t reserved8  :  8;
    };
    uint16_t VALUE16;
  };
} ADI_I2C_ID3_t;
#endif /* !__ADI_NO_DECL_STRUCT_ADI_I2C_ID3_t__ */

/*@}*/

/** @defgroup STAT Master and slave FIFO status (STAT) Register
 *  Master and slave FIFO status (STAT) Register.
 *  @{
 */

/* ==========================================================================
 *! \struct ADI_I2C_STAT_Struct
 *! \brief  Master and slave FIFO status Register bit field structure
 * ========================================================================== */
#ifndef __ADI_NO_DECL_STRUCT_ADI_I2C_STAT_t__
typedef struct _ADI_I2C_STAT_t {
  union {
    struct {
      uint16_t STXF       :  2;  /**< Slave transmit FIFO status */
      uint16_t SRXF       :  2;  /**< Slave receive FIFO status */
      uint16_t MTXF       :  2;  /**< Master transmit FIFO status */
      uint16_t MRXF       :  2;  /**< Master receive FIFO status */
      uint16_t SFLUSH     :  1;  /**< Flush the slave transmit FIFO */
      uint16_t MFLUSH     :  1;  /**< Flush the master transmit FIFO */
      uint16_t reserved10 :  6;
    };
    uint16_t VALUE16;
  };
} ADI_I2C_STAT_t;
#endif /* !__ADI_NO_DECL_STRUCT_ADI_I2C_STAT_t__ */

/*@}*/

/** @defgroup SHCTL Shared control (SHCTL) Register
 *  Shared control (SHCTL) Register.
 *  @{
 */

/* ==========================================================================
 *! \struct ADI_I2C_SHCTL_Struct
 *! \brief  Shared control Register bit field structure
 * ========================================================================== */
#ifndef __ADI_NO_DECL_STRUCT_ADI_I2C_SHCTL_t__
typedef struct _ADI_I2C_SHCTL_t {
  union {
    struct {
      uint16_t RST        :  1;  /**< Reset START STOP detect circuit */
      uint16_t reserved1  : 15;
    };
    uint16_t VALUE16;
  };
} ADI_I2C_SHCTL_t;
#endif /* !__ADI_NO_DECL_STRUCT_ADI_I2C_SHCTL_t__ */

/*@}*/

/** @defgroup TCTL Timing Control Register (TCTL) Register
 *  Timing Control Register (TCTL) Register.
 *  @{
 */

/* ==========================================================================
 *! \struct ADI_I2C_TCTL_Struct
 *! \brief  Timing Control Register bit field structure
 * ========================================================================== */
#ifndef __ADI_NO_DECL_STRUCT_ADI_I2C_TCTL_t__
typedef struct _ADI_I2C_TCTL_t {
  union {
    struct {
      uint16_t THDATIN    :  5;  /**< Data In Hold Start */
      uint16_t reserved5  :  3;
      uint16_t FILTEROFF  :  1;  /**< Input Filter Control */
      uint16_t reserved9  :  7;
    };
    uint16_t VALUE16;
  };
} ADI_I2C_TCTL_t;
#endif /* !__ADI_NO_DECL_STRUCT_ADI_I2C_TCTL_t__ */

/*@}*/

/** @defgroup ASTRETCH_SCL Automatic stretch SCL register (ASTRETCH_SCL) Register
 *  Automatic stretch SCL register (ASTRETCH_SCL) Register.
 *  @{
 */

/* ==========================================================================
 *! \struct ADI_I2C_ASTRETCH_SCL_Struct
 *! \brief  Automatic stretch SCL Register bit field structure
 * ========================================================================== */
#ifndef __ADI_NO_DECL_STRUCT_ADI_I2C_ASTRETCH_SCL_t__
typedef struct _ADI_I2C_ASTRETCH_SCL_t {
  union {
    struct {
      uint16_t MST        :  4;  /**< master automatic stretch mode */
      uint16_t SLV        :  4;  /**< slave automatic stretch mode */
      uint16_t MSTTMO     :  1;  /**< master automatic stretch timeout */
      uint16_t SLVTMO     :  1;  /**< slave automatic stretch timeout */
      uint16_t reserved10 :  6;
    };
    uint16_t VALUE16;
  };
} ADI_I2C_ASTRETCH_SCL_t;
#endif /* !__ADI_NO_DECL_STRUCT_ADI_I2C_ASTRETCH_SCL_t__ */

/*@}*/

/** @defgroup STAT Status (STAT) Register
 *  Status (STAT) Register.
 *  @{
 */

/* ==========================================================================
 *! \struct ADI_SPI_STAT_Struct
 *! \brief  Status Register bit field structure
 * ========================================================================== */
#ifndef __ADI_NO_DECL_STRUCT_ADI_SPI_STAT_t__
typedef struct _ADI_SPI_STAT_t {
  union {
    struct {
      uint16_t IRQ        :  1;  /**< SPI Interrupt status */
      uint16_t XFRDONE    :  1;  /**< SPI transfer completion */
      uint16_t TXEMPTY    :  1;  /**< SPI Tx FIFO empty interrupt */
      uint16_t TXDONE     :  1;  /**< SPI Tx Done in read command mode */
      uint16_t TXUNDR     :  1;  /**< SPI Tx FIFO underflow */
      uint16_t TXIRQ      :  1;  /**< SPI Tx IRQ */
      uint16_t RXIRQ      :  1;  /**< SPI Rx IRQ */
      uint16_t RXOVR      :  1;  /**< SPI Rx FIFO overflow */
      uint16_t reserved8  :  3;
      uint16_t CS         :  1;  /**< CS Status */
      uint16_t CSERR      :  1;  /**< Detected a CS error condition in slave mode */
	  uint16_t CSRISE     :  1;  /**< Detected a rising edge on CS, in slave CON mode */
      uint16_t CSFALL     :  1;  /**< Detected a falling edge on CS, in slave CON mode */
      uint16_t RDY        :  1;  /**< Detected an edge on Ready indicator for flow-control */
    };
    uint16_t VALUE16;
  };
} ADI_SPI_STAT_t;
#endif /* !__ADI_NO_DECL_STRUCT_ADI_SPI_STAT_t__ */

/*@}*/

/** @defgroup RX Receive (RX) Register
 *  Receive (RX) Register.
 *  @{
 */

/* ==========================================================================
 *! \struct ADI_SPI_RX_Struct
 *! \brief  Receive Register bit field structure
 * ========================================================================== */
#ifndef __ADI_NO_DECL_STRUCT_ADI_SPI_RX_t__
typedef struct _ADI_SPI_RX_t {
  union {
    struct {
      uint16_t BYTE1      :  8;  /**< 8-bit receive buffer */
      uint16_t BYTE2      :  8;  /**< 8-bit receive buffer, used only in DMA modes */
    };
    uint16_t VALUE16;
  };
} ADI_SPI_RX_t;
#endif /* !__ADI_NO_DECL_STRUCT_ADI_SPI_RX_t__ */

/*@}*/

/** @defgroup TX Transmit (TX) Register
 *  Transmit (TX) Register.
 *  @{
 */

/* ==========================================================================
 *! \struct ADI_SPI_TX_Struct
 *! \brief  Transmit Register bit field structure
 * ========================================================================== */
#ifndef __ADI_NO_DECL_STRUCT_ADI_SPI_TX_t__
typedef struct _ADI_SPI_TX_t {
  union {
    struct {
      uint16_t BYTE1      :  8;  /**< 8-bit transmit buffer */
      uint16_t BYTE2      :  8;  /**< 8-bit transmit buffer, used only in DMA modes */
    };
    uint16_t VALUE16;
  };
} ADI_SPI_TX_t;
#endif /* !__ADI_NO_DECL_STRUCT_ADI_SPI_TX_t__ */

/*@}*/

/** @defgroup DIV SPI baud rate selection (DIV) Register
 *  SPI baud rate selection (DIV) Register.
 *  @{
 */

/* ==========================================================================
 *! \struct ADI_SPI_DIV_Struct
 *! \brief  SPI baud rate selection Register bit field structure
 * ========================================================================== */
#ifndef __ADI_NO_DECL_STRUCT_ADI_SPI_DIV_t__
typedef struct _ADI_SPI_DIV_t {
  union {
    struct {
      uint16_t VALUE      :  6;  /**< SPI clock divider */
      uint16_t reserved6  : 10;
    };
    uint16_t VALUE16;
  };
} ADI_SPI_DIV_t;
#endif /* !__ADI_NO_DECL_STRUCT_ADI_SPI_DIV_t__ */

/*@}*/

/** @defgroup CTL SPI configuration 1 (CTL) Register
 *  SPI configuration 1 (CTL) Register.
 *  @{
 */

/* ==========================================================================
 *! \struct ADI_SPI_CTL_Struct
 *! \brief  SPI configuration 1 Register bit field structure
 * ========================================================================== */
#ifndef __ADI_NO_DECL_STRUCT_ADI_SPI_CTL_t__
typedef struct _ADI_SPI_CTL_t {
  union {
    struct {
      uint16_t SPIEN      :  1;  /**< SPI enable */
      uint16_t MASEN      :  1;  /**< Master mode enable */
      uint16_t CPHA       :  1;  /**< Serial clock phase mode */
      uint16_t CPOL       :  1;  /**< Serial Clock Polarity */
      uint16_t WOM        :  1;  /**< SPI Wired Or mode */
      uint16_t LSB        :  1;  /**< LSB first transfer enable */
      uint16_t TIM        :  1;  /**< SPI transfer and interrupt mode */
      uint16_t ZEN        :  1;  /**< Transmit zeros enable */
      uint16_t RXOF       :  1;  /**< RX overflow overwrite enable */
      uint16_t OEN        :  1;  /**< Slave MISO output enable */
      uint16_t LOOPBACK   :  1;  /**< Loopback enable */
      uint16_t CON        :  1;  /**< Continuous transfer enable */
      uint16_t RFLUSH     :  1;  /**< SPI Rx FIFO Flush enable */
      uint16_t TFLUSH     :  1;  /**< SPI Tx FIFO Flush enable */
      uint16_t CSRST      :  1;  /**< Reset Mode for CS Error bit */
      uint16_t reserved15 :  1;
    };
    uint16_t VALUE16;
  };
} ADI_SPI_CTL_t;
#endif /* !__ADI_NO_DECL_STRUCT_ADI_SPI_CTL_t__ */

/*@}*/

/** @defgroup IEN SPI configuration 2 (IEN) Register
 *  SPI configuration 2 (IEN) Register.
 *  @{
 */

/* ==========================================================================
 *! \struct ADI_SPI_IEN_Struct
 *! \brief  SPI configuration 2 Register bit field structure
 * ========================================================================== */
#ifndef __ADI_NO_DECL_STRUCT_ADI_SPI_IEN_t__
typedef struct _ADI_SPI_IEN_t {
  union {
    struct {
      uint16_t IRQMODE    :  3;  /**< SPI IRQ mode bits */
      uint16_t reserved3  :  5;
      uint16_t CS         :  1;  /**< Enable interrupt on every CS edge in slave CON mode */
      uint16_t TXUNDR     :  1;  /**< Tx-underflow interrupt enable */
      uint16_t RXOVR      :  1;  /**< Rx-overflow interrupt enable */
      uint16_t RDY        :  1;  /**< Ready signal edge interrupt enable */
      uint16_t TXDONE     :  1;  /**< SPI transmit done interrupt enable */
      uint16_t XFRDONE    :  1;  /**< SPI transfer completion interrupt enable */
      uint16_t TXEMPTY    :  1;  /**< Tx-FIFO Empty interrupt enable */
      uint16_t reserved15 :  1;
    };
    uint16_t VALUE16;
  };
} ADI_SPI_IEN_t;
#endif /* !__ADI_NO_DECL_STRUCT_ADI_SPI_IEN_t__ */

/*@}*/

/** @defgroup CNT Transfer byte count (CNT) Register
 *  Transfer byte count (CNT) Register.
 *  @{
 */

/* ==========================================================================
 *! \struct ADI_SPI_CNT_Struct
 *! \brief  Transfer byte count Register bit field structure
 * ========================================================================== */
#ifndef __ADI_NO_DECL_STRUCT_ADI_SPI_CNT_t__
typedef struct _ADI_SPI_CNT_t {
  union {
    struct {
      uint16_t VALUE      : 14;  /**< Transfer byte count */
      uint16_t reserved14 :  1;
      uint16_t FRAMECONT  :  1;  /**< Continue frame */
    };
    uint16_t VALUE16;
  };
} ADI_SPI_CNT_t;
#endif /* !__ADI_NO_DECL_STRUCT_ADI_SPI_CNT_t__ */

/*@}*/

/** @defgroup DMA SPI DMA enable (DMA) Register
 *  SPI DMA enable (DMA) Register.
 *  @{
 */

/* ==========================================================================
 *! \struct ADI_SPI_DMA_Struct
 *! \brief  SPI DMA enable Register bit field structure
 * ========================================================================== */
#ifndef __ADI_NO_DECL_STRUCT_ADI_SPI_DMA_t__
typedef struct _ADI_SPI_DMA_t {
  union {
    struct {
      uint16_t EN         :  1;  /**< Enable DMA for data transfer */
      uint16_t TXEN       :  1;  /**< Enable transmit DMA request */
      uint16_t RXEN       :  1;  /**< Enable receive DMA request */
      uint16_t reserved3  : 13;
    };
    uint16_t VALUE16;
  };
} ADI_SPI_DMA_t;
#endif /* !__ADI_NO_DECL_STRUCT_ADI_SPI_DMA_t__ */

/*@}*/

/** @defgroup FIFO_STAT FIFO Status (FIFO_STAT) Register
 *  FIFO Status (FIFO_STAT) Register.
 *  @{
 */

/* ==========================================================================
 *! \struct ADI_SPI_FIFO_STAT_Struct
 *! \brief  FIFO Status Register bit field structure
 * ========================================================================== */
#ifndef __ADI_NO_DECL_STRUCT_ADI_SPI_FIFO_STAT_t__
typedef struct _ADI_SPI_FIFO_STAT_t {
  union {
    struct {
      uint16_t TX         :  4;  /**< SPI Tx FIFO status */
      uint16_t reserved4  :  4;
      uint16_t RX         :  4;  /**< SPI Rx FIFO status */
      uint16_t reserved12 :  4;
    };
    uint16_t VALUE16;
  };
} ADI_SPI_FIFO_STAT_t;
#endif /* !__ADI_NO_DECL_STRUCT_ADI_SPI_FIFO_STAT_t__ */

/*@}*/

/** @defgroup RD_CTL Read Control (RD_CTL) Register
 *  Read Control (RD_CTL) Register.
 *  @{
 */

/* ==========================================================================
 *! \struct ADI_SPI_RD_CTL_Struct
 *! \brief  Read Control Register bit field structure
 * ========================================================================== */
#ifndef __ADI_NO_DECL_STRUCT_ADI_SPI_RD_CTL_t__
typedef struct _ADI_SPI_RD_CTL_t {
  union {
    struct {
      uint16_t CMDEN      :  1;  /**< Read command enable */
      uint16_t OVERLAP    :  1;  /**< Tx/Rx Overlap mode */
      uint16_t TXBYTES    :  4;  /**< Transmit byte count minus 1 for read command */
      uint16_t reserved6  :  2;
      uint16_t THREEPIN   :  1;  /**< Three pin SPI mode */
      uint16_t reserved9  :  7;
    };
    uint16_t VALUE16;
  };
} ADI_SPI_RD_CTL_t;
#endif /* !__ADI_NO_DECL_STRUCT_ADI_SPI_RD_CTL_t__ */

/*@}*/

/** @defgroup FLOW_CTL Flow Control (FLOW_CTL) Register
 *  Flow Control (FLOW_CTL) Register.
 *  @{
 */

/* ==========================================================================
 *! \struct ADI_SPI_FLOW_CTL_Struct
 *! \brief  Flow Control Register bit field structure
 * ========================================================================== */
#ifndef __ADI_NO_DECL_STRUCT_ADI_SPI_FLOW_CTL_t__
typedef struct _ADI_SPI_FLOW_CTL_t {
  union {
    struct {
      uint16_t MODE       :  2;  /**< Flow control mode */
      uint16_t reserved2  :  2;
      uint16_t RDYPOL     :  1;  /**< Polarity of RDY/MISO line */
      uint16_t reserved5  :  3;
      uint16_t RDBURSTSZ  :  4;  /**< Read data burst size minus 1 */
      uint16_t reserved12 :  4;
    };
    uint16_t VALUE16;
  };
} ADI_SPI_FLOW_CTL_t;
#endif /* !__ADI_NO_DECL_STRUCT_ADI_SPI_FLOW_CTL_t__ */

/*@}*/

/** @defgroup WAIT_TMR Wait timer for flow control (WAIT_TMR) Register
 *  Wait timer for flow control (WAIT_TMR) Register.
 *  @{
 */

/* ==========================================================================
 *! \struct ADI_SPI_WAIT_TMR_Struct
 *! \brief  Wait timer for flow control Register bit field structure
 * ========================================================================== */
#ifndef __ADI_NO_DECL_STRUCT_ADI_SPI_WAIT_TMR_t__
typedef struct _ADI_SPI_WAIT_TMR_t {
  union {
    struct {
      uint16_t VALUE      : 16;  /**< Wait timer for flow-control */
    };
    uint16_t VALUE16;
  };
} ADI_SPI_WAIT_TMR_t;
#endif /* !__ADI_NO_DECL_STRUCT_ADI_SPI_WAIT_TMR_t__ */

/*@}*/

/** @defgroup CS_CTL Chip-Select control for multi-slave connections (CS_CTL) Register
 *  Chip-Select control for multi-slave connections (CS_CTL) Register.
 *  @{
 */

/* ==========================================================================
 *! \struct ADI_SPI_CS_CTL_Struct
 *! \brief  Chip-Select control for multi-slave connections Register bit field structure
 * ========================================================================== */
#ifndef __ADI_NO_DECL_STRUCT_ADI_SPI_CS_CTL_t__
typedef struct _ADI_SPI_CS_CTL_t {
  union {
    struct {
      uint16_t SEL        :  4;  /**< Chip-Select control */
      uint16_t reserved4  : 12;
    };
    uint16_t VALUE16;
  };
} ADI_SPI_CS_CTL_t;
#endif /* !__ADI_NO_DECL_STRUCT_ADI_SPI_CS_CTL_t__ */

/*@}*/

/** @defgroup CS_OVERRIDE Chip-Select Override (CS_OVERRIDE) Register
 *  Chip-Select Override (CS_OVERRIDE) Register.
 *  @{
 */

/* ==========================================================================
 *! \struct ADI_SPI_CS_OVERRIDE_Struct
 *! \brief  Chip-Select Override Register bit field structure
 * ========================================================================== */
#ifndef __ADI_NO_DECL_STRUCT_ADI_SPI_CS_OVERRIDE_t__
typedef struct _ADI_SPI_CS_OVERRIDE_t {
  union {
    struct {
      uint16_t CTL        :  2;  /**< CS Override Control */
      uint16_t reserved2  : 14;
    };
    uint16_t VALUE16;
  };
} ADI_SPI_CS_OVERRIDE_t;
#endif /* !__ADI_NO_DECL_STRUCT_ADI_SPI_CS_OVERRIDE_t__ */

/*@}*/

/** @defgroup COMRX Receive Buffer Register (COMRX) Register
 *  Receive Buffer Register (COMRX) Register.
 *  @{
 */

/* ==========================================================================
 *! \struct ADI_UART_COMRX_Struct
 *! \brief  Receive Buffer Register bit field structure
 * ========================================================================== */
#ifndef __ADI_NO_DECL_STRUCT_ADI_UART_COMRX_t__
typedef struct _ADI_UART_COMRX_t {
  union {
    struct {
      uint16_t RBR        :  8;  /**< Receive Buffer Register */
      uint16_t reserved8  :  8;
    };
    uint16_t VALUE16;
  };
} ADI_UART_COMRX_t;
#endif /* !__ADI_NO_DECL_STRUCT_ADI_UART_COMRX_t__ */

/*@}*/

/** @defgroup COMTX Transmit Holding Register (COMTX) Register
 *  Transmit Holding Register (COMTX) Register.
 *  @{
 */

/* ==========================================================================
 *! \struct ADI_UART_COMTX_Struct
 *! \brief  Transmit Holding Register bit field structure
 * ========================================================================== */
#ifndef __ADI_NO_DECL_STRUCT_ADI_UART_COMTX_t__
typedef struct _ADI_UART_COMTX_t {
  union {
    struct {
      uint16_t THR        :  8;  /**< Transmit Holding Register */
      uint16_t reserved8  :  8;
    };
    uint16_t VALUE16;
  };
} ADI_UART_COMTX_t;
#endif /* !__ADI_NO_DECL_STRUCT_ADI_UART_COMTX_t__ */

/*@}*/

/** @defgroup COMIEN Interrupt Enable (COMIEN) Register
 *  Interrupt Enable (COMIEN) Register.
 *  @{
 */

/* ==========================================================================
 *! \struct ADI_UART_COMIEN_Struct
 *! \brief  Interrupt Enable Register bit field structure
 * ========================================================================== */
#ifndef __ADI_NO_DECL_STRUCT_ADI_UART_COMIEN_t__
typedef struct _ADI_UART_COMIEN_t {
  union {
    struct {
      uint16_t ERBFI      :  1;  /**< Receive buffer full interrupt */
      uint16_t ETBEI      :  1;  /**< Transmit buffer empty interrupt */
      uint16_t ELSI       :  1;  /**< Rx status interrupt */
      uint16_t EDSSI      :  1;  /**< Modem status interrupt */
      uint16_t EDMAT      :  1;  /**< DMA requests in transmit mode */
      uint16_t EDMAR      :  1;  /**< DMA requests in receive mode */
      uint16_t reserved6  : 10;
    };
    uint16_t VALUE16;
  };
} ADI_UART_COMIEN_t;
#endif /* !__ADI_NO_DECL_STRUCT_ADI_UART_COMIEN_t__ */

/*@}*/

/** @defgroup COMIIR Interrupt ID (COMIIR) Register
 *  Interrupt ID (COMIIR) Register.
 *  @{
 */

/* ==========================================================================
 *! \struct ADI_UART_COMIIR_Struct
 *! \brief  Interrupt ID Register bit field structure
 * ========================================================================== */
#ifndef __ADI_NO_DECL_STRUCT_ADI_UART_COMIIR_t__
typedef struct _ADI_UART_COMIIR_t {
  union {
    struct {
      uint16_t NIRQ       :  1;  /**< Interrupt flag */
      uint16_t STA        :  3;  /**< Interrupt status */
      uint16_t reserved4  :  2;
      uint16_t FEND       :  2;  /**< FIFO enabled */
      uint16_t reserved8  :  8;
    };
    uint16_t VALUE16;
  };
} ADI_UART_COMIIR_t;
#endif /* !__ADI_NO_DECL_STRUCT_ADI_UART_COMIIR_t__ */

/*@}*/

/** @defgroup COMLCR Line Control (COMLCR) Register
 *  Line Control (COMLCR) Register.
 *  @{
 */

/* ==========================================================================
 *! \struct ADI_UART_COMLCR_Struct
 *! \brief  Line Control Register bit field structure
 * ========================================================================== */
#ifndef __ADI_NO_DECL_STRUCT_ADI_UART_COMLCR_t__
typedef struct _ADI_UART_COMLCR_t {
  union {
    struct {
      uint16_t WLS        :  2;  /**< Word Length Select */
      uint16_t STOP       :  1;  /**< Stop Bit */
      uint16_t PEN        :  1;  /**< Parity Enable */
      uint16_t EPS        :  1;  /**< Parity Select */
      uint16_t SP         :  1;  /**< Stick Parity */
      uint16_t BRK        :  1;  /**< Set Break */
      uint16_t reserved7  :  9;
    };
    uint16_t VALUE16;
  };
} ADI_UART_COMLCR_t;
#endif /* !__ADI_NO_DECL_STRUCT_ADI_UART_COMLCR_t__ */

/*@}*/

/** @defgroup COMMCR Modem Control (COMMCR) Register
 *  Modem Control (COMMCR) Register.
 *  @{
 */

/* ==========================================================================
 *! \struct ADI_UART_COMMCR_Struct
 *! \brief  Modem Control Register bit field structure
 * ========================================================================== */
#ifndef __ADI_NO_DECL_STRUCT_ADI_UART_COMMCR_t__
typedef struct _ADI_UART_COMMCR_t {
  union {
    struct {
      uint16_t DTR        :  1;  /**< Data Terminal Ready */
      uint16_t RTS        :  1;  /**< Request to send */
      uint16_t OUT1       :  1;  /**< Output 1 */
      uint16_t OUT2       :  1;  /**< Output 2 */
      uint16_t LOOPBACK   :  1;  /**< Loopback mode */
      uint16_t reserved5  : 11;
    };
    uint16_t VALUE16;
  };
} ADI_UART_COMMCR_t;
#endif /* !__ADI_NO_DECL_STRUCT_ADI_UART_COMMCR_t__ */

/*@}*/

/** @defgroup COMLSR Line Status (COMLSR) Register
 *  Line Status (COMLSR) Register.
 *  @{
 */

/* ==========================================================================
 *! \struct ADI_UART_COMLSR_Struct
 *! \brief  Line Status Register bit field structure
 * ========================================================================== */
#ifndef __ADI_NO_DECL_STRUCT_ADI_UART_COMLSR_t__
typedef struct _ADI_UART_COMLSR_t {
  union {
    struct {
      uint16_t DR         :  1;  /**< Data Ready */
      uint16_t OE         :  1;  /**< Overrun Error */
      uint16_t PE         :  1;  /**< Parity Error */
      uint16_t FE         :  1;  /**< Framing Error */
      uint16_t BI         :  1;  /**< Break Indicator */
      uint16_t THRE       :  1;  /**< COMTX Empty */
      uint16_t TEMT       :  1;  /**< COMTX and Shift Register Empty Status */
      uint16_t FIFOERR    :  1;  /**< data byte(s) in RX FIFO have either parity error, frame error or break indication. only used in 16550 mode; Read-clear if no more error in RX FIFO */
      uint16_t reserved8  :  8;
    };
    uint16_t VALUE16;
  };
} ADI_UART_COMLSR_t;
#endif /* !__ADI_NO_DECL_STRUCT_ADI_UART_COMLSR_t__ */

/*@}*/

/** @defgroup COMMSR Modem Status (COMMSR) Register
 *  Modem Status (COMMSR) Register.
 *  @{
 */

/* ==========================================================================
 *! \struct ADI_UART_COMMSR_Struct
 *! \brief  Modem Status Register bit field structure
 * ========================================================================== */
#ifndef __ADI_NO_DECL_STRUCT_ADI_UART_COMMSR_t__
typedef struct _ADI_UART_COMMSR_t {
  union {
    struct {
      uint16_t DCTS       :  1;  /**< Delta CTS */
      uint16_t DDSR       :  1;  /**< Delta DSR */
      uint16_t TERI       :  1;  /**< Trailing Edge RI */
      uint16_t DDCD       :  1;  /**< Delta DCD */
      uint16_t CTS        :  1;  /**< Clear To Send */
      uint16_t DSR        :  1;  /**< Data Set Ready */
      uint16_t RI         :  1;  /**< Ring Indicator */
      uint16_t DCD        :  1;  /**< Data Carrier Detect */
      uint16_t reserved8  :  8;
    };
    uint16_t VALUE16;
  };
} ADI_UART_COMMSR_t;
#endif /* !__ADI_NO_DECL_STRUCT_ADI_UART_COMMSR_t__ */

/*@}*/

/** @defgroup COMSCR Scratch buffer (COMSCR) Register
 *  Scratch buffer (COMSCR) Register.
 *  @{
 */

/* ==========================================================================
 *! \struct ADI_UART_COMSCR_Struct
 *! \brief  Scratch buffer Register bit field structure
 * ========================================================================== */
#ifndef __ADI_NO_DECL_STRUCT_ADI_UART_COMSCR_t__
typedef struct _ADI_UART_COMSCR_t {
  union {
    struct {
      uint16_t SCR        :  8;  /**< Scratch */
      uint16_t reserved8  :  8;
    };
    uint16_t VALUE16;
  };
} ADI_UART_COMSCR_t;
#endif /* !__ADI_NO_DECL_STRUCT_ADI_UART_COMSCR_t__ */

/*@}*/

/** @defgroup COMFCR FIFO Control (COMFCR) Register
 *  FIFO Control (COMFCR) Register.
 *  @{
 */

/*  =========================================================================
 *! \enum   ADI_UART_COMFCR_FDMAMD
 *! \brief  FIFO DMA mode (FDMAMD) Enumerations
 *  ========================================================================= */
typedef enum
{
  UART_COMFCR_MODE0 = 0,  /**< in DMA mode 0, RX DMA request will be asserted whenever there's data in RBR or RX FIFO and de-assert whenever RBR or RX FIFO is empty; TX DMA request will be asserted whenever THR or TX FIFO is empty and de-assert whenever data written to                               */
  UART_COMFCR_MODE1 = 1   /**< in DMA mode 1, RX DMA request will be asserted whenever RX FIFO trig level or time out reached and de-assert thereafter when RX FIFO is empty; TX DMA request will be asserted whenever TX FIFO is empty and de-assert thereafter when TX FIFO is completely filled up full; */
} ADI_UART_COMFCR_FDMAMD;


/* ==========================================================================
 *! \struct ADI_UART_COMFCR_Struct
 *! \brief  FIFO Control Register bit field structure
 * ========================================================================== */
#ifndef __ADI_NO_DECL_STRUCT_ADI_UART_COMFCR_t__
typedef struct _ADI_UART_COMFCR_t {
  union {
    struct {
      uint16_t FIFOEN     :  1;  /**< FIFO enable as to work in 16550 mode */
      uint16_t RFCLR      :  1;  /**< clear RX FIFO */
      uint16_t TFCLR      :  1;  /**< clear TX FIFO */
      uint16_t FDMAMD     :  1;  /**< FIFO DMA mode */
      uint16_t reserved4  :  2;
      uint16_t RFTRIG     :  2;  /**< RX FIFO Trig level */
      uint16_t reserved8  :  8;
    };
    uint16_t VALUE16;
  };
} ADI_UART_COMFCR_t;
#endif /* !__ADI_NO_DECL_STRUCT_ADI_UART_COMFCR_t__ */

/*@}*/

/** @defgroup COMFBR Fractional Baud Rate (COMFBR) Register
 *  Fractional Baud Rate (COMFBR) Register.
 *  @{
 */

/* ==========================================================================
 *! \struct ADI_UART_COMFBR_Struct
 *! \brief  Fractional Baud Rate Register bit field structure
 * ========================================================================== */
#ifndef __ADI_NO_DECL_STRUCT_ADI_UART_COMFBR_t__
typedef struct _ADI_UART_COMFBR_t {
  union {
    struct {
      uint16_t DIVN       : 11;  /**< Fractional baud rate N divide bits 0 to 2047. */
      uint16_t DIVM       :  2;  /**< Fractional baud rate M divide bits 1 to 3 */
      uint16_t reserved13 :  2;
      uint16_t FBEN       :  1;  /**< Fractional baud rate generator enable */
    };
    uint16_t VALUE16;
  };
} ADI_UART_COMFBR_t;
#endif /* !__ADI_NO_DECL_STRUCT_ADI_UART_COMFBR_t__ */

/*@}*/

/** @defgroup COMDIV Baudrate divider (COMDIV) Register
 *  Baudrate divider (COMDIV) Register.
 *  @{
 */

/* ==========================================================================
 *! \struct ADI_UART_COMDIV_Struct
 *! \brief  Baudrate divider Register bit field structure
 * ========================================================================== */
#ifndef __ADI_NO_DECL_STRUCT_ADI_UART_COMDIV_t__
typedef struct _ADI_UART_COMDIV_t {
  union {
    struct {
      int16_t DIV        : 16;  /**< Baud rate divider */
    };
    int16_t VALUE16;
  };
} ADI_UART_COMDIV_t;
#endif /* !__ADI_NO_DECL_STRUCT_ADI_UART_COMDIV_t__ */

/*@}*/

/** @defgroup COMLCR2 second Line Control (COMLCR2) Register
 *  second Line Control (COMLCR2) Register.
 *  @{
 */

/* ==========================================================================
 *! \struct ADI_UART_COMLCR2_Struct
 *! \brief  second Line Control Register bit field structure
 * ========================================================================== */
#ifndef __ADI_NO_DECL_STRUCT_ADI_UART_COMLCR2_t__
typedef struct _ADI_UART_COMLCR2_t {
  union {
    struct {
      uint16_t OSR        :  2;  /**< Over Sample Rate */
      uint16_t reserved2  : 14;
    };
    uint16_t VALUE16;
  };
} ADI_UART_COMLCR2_t;
#endif /* !__ADI_NO_DECL_STRUCT_ADI_UART_COMLCR2_t__ */

/*@}*/

/** @defgroup COMCTL UART control register (COMCTL) Register
 *  UART control register (COMCTL) Register.
 *  @{
 */

/*  =========================================================================
 *! \enum   ADI_UART_COMCTL_RXINV
 *! \brief  invert receiver line (RXINV) Enumerations
 *  ========================================================================= */
typedef enum
{
  UART_COMCTL_EN000 = 0,  /**< don't invert receiver line (idling high) */
  UART_COMCTL_EN001 = 1   /**< invert receiver line (idling low)        */
} ADI_UART_COMCTL_RXINV;


/* ==========================================================================
 *! \struct ADI_UART_COMCTL_Struct
 *! \brief  UART control Register bit field structure
 * ========================================================================== */
#ifndef __ADI_NO_DECL_STRUCT_ADI_UART_COMCTL_t__
typedef struct _ADI_UART_COMCTL_t {
  union {
    struct {
      uint16_t reserved0  :  1;
      uint16_t ForceClkOn :  1;  /**< Force UCLKg on */
      uint16_t reserved2  :  2;
      uint16_t RXINV      :  1;  /**< invert receiver line */
      uint16_t reserved5  :  3;
      uint16_t REV        :  8;  /**< UART revision ID */
    };
    uint16_t VALUE16;
  };
} ADI_UART_COMCTL_t;
#endif /* !__ADI_NO_DECL_STRUCT_ADI_UART_COMCTL_t__ */

/*@}*/

/** @defgroup COMRFC RX FIFO byte count (COMRFC) Register
 *  RX FIFO byte count (COMRFC) Register.
 *  @{
 */

/* ==========================================================================
 *! \struct ADI_UART_COMRFC_Struct
 *! \brief  RX FIFO byte count Register bit field structure
 * ========================================================================== */
#ifndef __ADI_NO_DECL_STRUCT_ADI_UART_COMRFC_t__
typedef struct _ADI_UART_COMRFC_t {
  union {
    struct {
      uint16_t RFC        :  5;  /**< Current RX FIFO data bytes */
      uint16_t reserved5  : 11;
    };
    uint16_t VALUE16;
  };
} ADI_UART_COMRFC_t;
#endif /* !__ADI_NO_DECL_STRUCT_ADI_UART_COMRFC_t__ */

/*@}*/

/** @defgroup COMTFC TX FIFO byte count (COMTFC) Register
 *  TX FIFO byte count (COMTFC) Register.
 *  @{
 */

/* ==========================================================================
 *! \struct ADI_UART_COMTFC_Struct
 *! \brief  TX FIFO byte count Register bit field structure
 * ========================================================================== */
#ifndef __ADI_NO_DECL_STRUCT_ADI_UART_COMTFC_t__
typedef struct _ADI_UART_COMTFC_t {
  union {
    struct {
      uint16_t TFC        :  5;  /**< Current TX FIFO data bytes */
      uint16_t reserved5  : 11;
    };
    uint16_t VALUE16;
  };
} ADI_UART_COMTFC_t;
#endif /* !__ADI_NO_DECL_STRUCT_ADI_UART_COMTFC_t__ */

/*@}*/

/** @defgroup COMRSC RS485 half-duplex Control (COMRSC) Register
 *  RS485 half-duplex Control (COMRSC) Register.
 *  @{
 */

/* ==========================================================================
 *! \struct ADI_UART_COMRSC_Struct
 *! \brief  RS485 half-duplex Control Register bit field structure
 * ========================================================================== */
#ifndef __ADI_NO_DECL_STRUCT_ADI_UART_COMRSC_t__
typedef struct _ADI_UART_COMRSC_t {
  union {
    struct {
      uint16_t OENP       :  1;  /**< SOUT_EN polarity */
      uint16_t OENSP      :  1;  /**< SOUT_EN de-assert before full stop bit(s) */
      uint16_t DISRX      :  1;  /**< disable RX when transmitting */
      uint16_t DISTX      :  1;  /**< Hold off TX when receiving */
      uint16_t reserved4  : 12;
    };
    uint16_t VALUE16;
  };
} ADI_UART_COMRSC_t;
#endif /* !__ADI_NO_DECL_STRUCT_ADI_UART_COMRSC_t__ */

/*@}*/

/** @defgroup COMACR Auto Baud Control (COMACR) Register
 *  Auto Baud Control (COMACR) Register.
 *  @{
 */

/* ==========================================================================
 *! \struct ADI_UART_COMACR_Struct
 *! \brief  Auto Baud Control Register bit field structure
 * ========================================================================== */
#ifndef __ADI_NO_DECL_STRUCT_ADI_UART_COMACR_t__
typedef struct _ADI_UART_COMACR_t {
  union {
    struct {
      uint16_t ABE        :  1;  /**< Auto Baud enable */
      uint16_t DNIEN      :  1;  /**< enable done interrupt */
      uint16_t TOIEN      :  1;  /**< enable time-out interrupt */
      uint16_t reserved3  :  1;
      uint16_t SEC        :  3;  /**< Starting Edge Count */
      uint16_t reserved7  :  1;
      uint16_t EEC        :  4;  /**< Ending Edge Count */
      uint16_t reserved12 :  4;
    };
    uint16_t VALUE16;
  };
} ADI_UART_COMACR_t;
#endif /* !__ADI_NO_DECL_STRUCT_ADI_UART_COMACR_t__ */

/*@}*/

/** @defgroup COMASRL Auto Baud Status (Low) (COMASRL) Register
 *  Auto Baud Status (Low) (COMASRL) Register.
 *  @{
 */

/* ==========================================================================
 *! \struct ADI_UART_COMASRL_Struct
 *! \brief  Auto Baud Status (Low) Register bit field structure
 * ========================================================================== */
#ifndef __ADI_NO_DECL_STRUCT_ADI_UART_COMASRL_t__
typedef struct _ADI_UART_COMASRL_t {
  union {
    struct {
      uint16_t DONE       :  1;  /**< Auto Baud Done successfully */
      uint16_t BRKTO      :  1;  /**< Timed out due to long time break condition */
      uint16_t NSETO      :  1;  /**< Timed out due to no valid start edge found */
      uint16_t NEETO      :  1;  /**< Timed out due to no valid ending edge found */
      uint16_t CNT        : 12;  /**< CNT[11:0] Auto Baud Counter value */
    };
    uint16_t VALUE16;
  };
} ADI_UART_COMASRL_t;
#endif /* !__ADI_NO_DECL_STRUCT_ADI_UART_COMASRL_t__ */

/*@}*/

/** @defgroup COMASRH Auto Baud Status (High) (COMASRH) Register
 *  Auto Baud Status (High) (COMASRH) Register.
 *  @{
 */

/* ==========================================================================
 *! \struct ADI_UART_COMASRH_Struct
 *! \brief  Auto Baud Status (High) Register bit field structure
 * ========================================================================== */
#ifndef __ADI_NO_DECL_STRUCT_ADI_UART_COMASRH_t__
typedef struct _ADI_UART_COMASRH_t {
  union {
    struct {
      uint16_t CNT        :  8;  /**< CNT[19:12] Auto Baud Counter value */
      uint16_t reserved8  :  8;
    };
    uint16_t VALUE16;
  };
} ADI_UART_COMASRH_t;
#endif /* !__ADI_NO_DECL_STRUCT_ADI_UART_COMASRH_t__ */

/*@}*/

/** @defgroup STAT DMA Status (STAT) Register
 *  DMA Status (STAT) Register.
 *  @{
 */

/* ==========================================================================
 *! \struct ADI_DMA_STAT_Struct
 *! \brief  DMA Status Register bit field structure
 * ========================================================================== */
#ifndef __ADI_NO_DECL_STRUCT_ADI_DMA_STAT_t__
typedef struct _ADI_DMA_STAT_t {
  union {
    struct {
      uint32_t MEN        :  1;  /**< Enable status of the controller */
      uint32_t reserved1  : 15;
      uint32_t CHANM1     :  5;  /**< Number of available DMA channels minus 1 */
      uint32_t reserved21 : 11;
    };
    uint32_t VALUE32;
  };
} ADI_DMA_STAT_t;
#endif /* !__ADI_NO_DECL_STRUCT_ADI_DMA_STAT_t__ */

/*@}*/

/** @defgroup CFG DMA Configuration (CFG) Register
 *  DMA Configuration (CFG) Register.
 *  @{
 */

/* ==========================================================================
 *! \struct ADI_DMA_CFG_Struct
 *! \brief  DMA Configuration Register bit field structure
 * ========================================================================== */
#ifndef __ADI_NO_DECL_STRUCT_ADI_DMA_CFG_t__
typedef struct _ADI_DMA_CFG_t {
  union {
    struct {
      uint32_t MEN        :  1;  /**< Controller enable */
      uint32_t reserved1  : 31;
    };
    uint32_t VALUE32;
  };
} ADI_DMA_CFG_t;
#endif /* !__ADI_NO_DECL_STRUCT_ADI_DMA_CFG_t__ */

/*@}*/

/** @defgroup PDBPTR DMA channel primary control data base pointer (PDBPTR) Register
 *  DMA channel primary control data base pointer (PDBPTR) Register.
 *  @{
 */

/* ==========================================================================
 *! \struct ADI_DMA_PDBPTR_Struct
 *! \brief  DMA channel primary control data base pointer Register bit field structure
 * ========================================================================== */
#ifndef __ADI_NO_DECL_STRUCT_ADI_DMA_PDBPTR_t__
typedef struct _ADI_DMA_PDBPTR_t {
  union {
    struct {
      int32_t ADDR       : 32;  /**< Pointer to the base address of the primary data structure */
    };
    int32_t VALUE32;
  };
} ADI_DMA_PDBPTR_t;
#endif /* !__ADI_NO_DECL_STRUCT_ADI_DMA_PDBPTR_t__ */

/*@}*/

/** @defgroup ADBPTR DMA channel alternate control data base pointer (ADBPTR) Register
 *  DMA channel alternate control data base pointer (ADBPTR) Register.
 *  @{
 */

/* ==========================================================================
 *! \struct ADI_DMA_ADBPTR_Struct
 *! \brief  DMA channel alternate control data base pointer Register bit field structure
 * ========================================================================== */
#ifndef __ADI_NO_DECL_STRUCT_ADI_DMA_ADBPTR_t__
typedef struct _ADI_DMA_ADBPTR_t {
  union {
    struct {
      int32_t ADDR       : 32;  /**< Base address of the alternate data structure */
    };
    int32_t VALUE32;
  };
} ADI_DMA_ADBPTR_t;
#endif /* !__ADI_NO_DECL_STRUCT_ADI_DMA_ADBPTR_t__ */

/*@}*/

/** @defgroup SWREQ DMA channel software request (SWREQ) Register
 *  DMA channel software request (SWREQ) Register.
 *  @{
 */

/* ==========================================================================
 *! \struct ADI_DMA_SWREQ_Struct
 *! \brief  DMA channel software request Register bit field structure
 * ========================================================================== */
#ifndef __ADI_NO_DECL_STRUCT_ADI_DMA_SWREQ_t__
typedef struct _ADI_DMA_SWREQ_t {
  union {
    struct {
      uint32_t CHAN       : 24;  /**< Generate software request */
      uint32_t reserved24 :  8;
    };
    uint32_t VALUE32;
  };
} ADI_DMA_SWREQ_t;
#endif /* !__ADI_NO_DECL_STRUCT_ADI_DMA_SWREQ_t__ */

/*@}*/

/** @defgroup RMSK_SET DMA channel request mask set (RMSK_SET) Register
 *  DMA channel request mask set (RMSK_SET) Register.
 *  @{
 */

/* ==========================================================================
 *! \struct ADI_DMA_RMSK_SET_Struct
 *! \brief  DMA channel request mask set Register bit field structure
 * ========================================================================== */
#ifndef __ADI_NO_DECL_STRUCT_ADI_DMA_RMSK_SET_t__
typedef struct _ADI_DMA_RMSK_SET_t {
  union {
    struct {
      uint32_t CHAN       : 24;  /**< Mask requests from DMA channels */
      uint32_t reserved24 :  8;
    };
    uint32_t VALUE32;
  };
} ADI_DMA_RMSK_SET_t;
#endif /* !__ADI_NO_DECL_STRUCT_ADI_DMA_RMSK_SET_t__ */

/*@}*/

/** @defgroup RMSK_CLR DMA channel request mask clear (RMSK_CLR) Register
 *  DMA channel request mask clear (RMSK_CLR) Register.
 *  @{
 */

/* ==========================================================================
 *! \struct ADI_DMA_RMSK_CLR_Struct
 *! \brief  DMA channel request mask clear Register bit field structure
 * ========================================================================== */
#ifndef __ADI_NO_DECL_STRUCT_ADI_DMA_RMSK_CLR_t__
typedef struct _ADI_DMA_RMSK_CLR_t {
  union {
    struct {
      uint32_t CHAN       : 24;  /**< Clear Request Mask Set bits */
      uint32_t reserved24 :  8;
    };
    uint32_t VALUE32;
  };
} ADI_DMA_RMSK_CLR_t;
#endif /* !__ADI_NO_DECL_STRUCT_ADI_DMA_RMSK_CLR_t__ */

/*@}*/

/** @defgroup EN_SET DMA channel enable set (EN_SET) Register
 *  DMA channel enable set (EN_SET) Register.
 *  @{
 */

/* ==========================================================================
 *! \struct ADI_DMA_EN_SET_Struct
 *! \brief  DMA channel enable set Register bit field structure
 * ========================================================================== */
#ifndef __ADI_NO_DECL_STRUCT_ADI_DMA_EN_SET_t__
typedef struct _ADI_DMA_EN_SET_t {
  union {
    struct {
      uint32_t CHAN       : 24;  /**< Enable DMA channels */
      uint32_t reserved24 :  8;
    };
    uint32_t VALUE32;
  };
} ADI_DMA_EN_SET_t;
#endif /* !__ADI_NO_DECL_STRUCT_ADI_DMA_EN_SET_t__ */

/*@}*/

/** @defgroup EN_CLR DMA channel enable clear (EN_CLR) Register
 *  DMA channel enable clear (EN_CLR) Register.
 *  @{
 */

/* ==========================================================================
 *! \struct ADI_DMA_EN_CLR_Struct
 *! \brief  DMA channel enable clear Register bit field structure
 * ========================================================================== */
#ifndef __ADI_NO_DECL_STRUCT_ADI_DMA_EN_CLR_t__
typedef struct _ADI_DMA_EN_CLR_t {
  union {
    struct {
      uint32_t CHAN       : 24;  /**< Disable DMA channels */
      uint32_t reserved24 :  8;
    };
    uint32_t VALUE32;
  };
} ADI_DMA_EN_CLR_t;
#endif /* !__ADI_NO_DECL_STRUCT_ADI_DMA_EN_CLR_t__ */

/*@}*/

/** @defgroup ALT_SET DMA channel primary-alternate set (ALT_SET) Register
 *  DMA channel primary-alternate set (ALT_SET) Register.
 *  @{
 */

/* ==========================================================================
 *! \struct ADI_DMA_ALT_SET_Struct
 *! \brief  DMA channel primary-alternate set Register bit field structure
 * ========================================================================== */
#ifndef __ADI_NO_DECL_STRUCT_ADI_DMA_ALT_SET_t__
typedef struct _ADI_DMA_ALT_SET_t {
  union {
    struct {
      uint32_t CHAN       : 24;  /**< Control struct status / select alt struct */
      uint32_t reserved24 :  8;
    };
    uint32_t VALUE32;
  };
} ADI_DMA_ALT_SET_t;
#endif /* !__ADI_NO_DECL_STRUCT_ADI_DMA_ALT_SET_t__ */

/*@}*/

/** @defgroup ALT_CLR DMA channel primary-alternate clear (ALT_CLR) Register
 *  DMA channel primary-alternate clear (ALT_CLR) Register.
 *  @{
 */

/* ==========================================================================
 *! \struct ADI_DMA_ALT_CLR_Struct
 *! \brief  DMA channel primary-alternate clear Register bit field structure
 * ========================================================================== */
#ifndef __ADI_NO_DECL_STRUCT_ADI_DMA_ALT_CLR_t__
typedef struct _ADI_DMA_ALT_CLR_t {
  union {
    struct {
      uint32_t CHAN       : 24;  /**< Select primary data struct */
      uint32_t reserved24 :  8;
    };
    uint32_t VALUE32;
  };
} ADI_DMA_ALT_CLR_t;
#endif /* !__ADI_NO_DECL_STRUCT_ADI_DMA_ALT_CLR_t__ */

/*@}*/

/** @defgroup PRI_SET DMA channel priority set (PRI_SET) Register
 *  DMA channel priority set (PRI_SET) Register.
 *  @{
 */

/* ==========================================================================
 *! \struct ADI_DMA_PRI_SET_Struct
 *! \brief  DMA channel priority set Register bit field structure
 * ========================================================================== */
#ifndef __ADI_NO_DECL_STRUCT_ADI_DMA_PRI_SET_t__
typedef struct _ADI_DMA_PRI_SET_t {
  union {
    struct {
      uint32_t CHAN       : 24;  /**< Configure channel for high priority */
      uint32_t reserved24 :  8;
    };
    uint32_t VALUE32;
  };
} ADI_DMA_PRI_SET_t;
#endif /* !__ADI_NO_DECL_STRUCT_ADI_DMA_PRI_SET_t__ */

/*@}*/

/** @defgroup PRI_CLR DMA channel priority clear (PRI_CLR) Register
 *  DMA channel priority clear (PRI_CLR) Register.
 *  @{
 */

/* ==========================================================================
 *! \struct ADI_DMA_PRI_CLR_Struct
 *! \brief  DMA channel priority clear Register bit field structure
 * ========================================================================== */
#ifndef __ADI_NO_DECL_STRUCT_ADI_DMA_PRI_CLR_t__
typedef struct _ADI_DMA_PRI_CLR_t {
  union {
    struct {
      uint32_t CHPRICLR   : 24;  /**< Configure channel for default priority level */
      uint32_t reserved24 :  8;
    };
    uint32_t VALUE32;
  };
} ADI_DMA_PRI_CLR_t;
#endif /* !__ADI_NO_DECL_STRUCT_ADI_DMA_PRI_CLR_t__ */

/*@}*/

/** @defgroup ERRCHNL_CLR DMA Per Channel Error Clear (ERRCHNL_CLR) Register
 *  DMA Per Channel Error Clear (ERRCHNL_CLR) Register.
 *  @{
 */

/* ==========================================================================
 *! \struct ADI_DMA_ERRCHNL_CLR_Struct
 *! \brief  DMA Per Channel Error Clear Register bit field structure
 * ========================================================================== */
#ifndef __ADI_NO_DECL_STRUCT_ADI_DMA_ERRCHNL_CLR_t__
typedef struct _ADI_DMA_ERRCHNL_CLR_t {
  union {
    struct {
      uint32_t CHAN       : 24;  /**< Per channel Bus error status/ Per channel bus error clear */
      uint32_t reserved24 :  8;
    };
    uint32_t VALUE32;
  };
} ADI_DMA_ERRCHNL_CLR_t;
#endif /* !__ADI_NO_DECL_STRUCT_ADI_DMA_ERRCHNL_CLR_t__ */

/*@}*/

/** @defgroup ERR_CLR DMA bus error clear (ERR_CLR) Register
 *  DMA bus error clear (ERR_CLR) Register.
 *  @{
 */

/* ==========================================================================
 *! \struct ADI_DMA_ERR_CLR_Struct
 *! \brief  DMA bus error clear Register bit field structure
 * ========================================================================== */
#ifndef __ADI_NO_DECL_STRUCT_ADI_DMA_ERR_CLR_t__
typedef struct _ADI_DMA_ERR_CLR_t {
  union {
    struct {
      uint32_t CHAN       : 24;  /**< Bus error status */
      uint32_t reserved24 :  8;
    };
    uint32_t VALUE32;
  };
} ADI_DMA_ERR_CLR_t;
#endif /* !__ADI_NO_DECL_STRUCT_ADI_DMA_ERR_CLR_t__ */

/*@}*/

/** @defgroup INVALIDDESC_CLR DMA Per Channel Invalid Descriptor Clear (INVALIDDESC_CLR) Register
 *  DMA Per Channel Invalid Descriptor Clear (INVALIDDESC_CLR) Register.
 *  @{
 */

/* ==========================================================================
 *! \struct ADI_DMA_INVALIDDESC_CLR_Struct
 *! \brief  DMA Per Channel Invalid Descriptor Clear Register bit field structure
 * ========================================================================== */
#ifndef __ADI_NO_DECL_STRUCT_ADI_DMA_INVALIDDESC_CLR_t__
typedef struct _ADI_DMA_INVALIDDESC_CLR_t {
  union {
    struct {
      uint32_t CHAN       : 24;  /**< Per channel Invalid Descriptor status/ Per channel Invalid descriptor status clear */
      uint32_t reserved24 :  8;
    };
    uint32_t VALUE32;
  };
} ADI_DMA_INVALIDDESC_CLR_t;
#endif /* !__ADI_NO_DECL_STRUCT_ADI_DMA_INVALIDDESC_CLR_t__ */

/*@}*/

/** @defgroup BS_SET DMA channel bytes swap enable set (BS_SET) Register
 *  DMA channel bytes swap enable set (BS_SET) Register.
 *  @{
 */

/* ==========================================================================
 *! \struct ADI_DMA_BS_SET_Struct
 *! \brief  DMA channel bytes swap enable set Register bit field structure
 * ========================================================================== */
#ifndef __ADI_NO_DECL_STRUCT_ADI_DMA_BS_SET_t__
typedef struct _ADI_DMA_BS_SET_t {
  union {
    struct {
      uint32_t CHAN       : 24;  /**< Byte swap status */
      uint32_t reserved24 :  8;
    };
    uint32_t VALUE32;
  };
} ADI_DMA_BS_SET_t;
#endif /* !__ADI_NO_DECL_STRUCT_ADI_DMA_BS_SET_t__ */

/*@}*/

/** @defgroup BS_CLR DMA channel bytes swap enable clear (BS_CLR) Register
 *  DMA channel bytes swap enable clear (BS_CLR) Register.
 *  @{
 */

/* ==========================================================================
 *! \struct ADI_DMA_BS_CLR_Struct
 *! \brief  DMA channel bytes swap enable clear Register bit field structure
 * ========================================================================== */
#ifndef __ADI_NO_DECL_STRUCT_ADI_DMA_BS_CLR_t__
typedef struct _ADI_DMA_BS_CLR_t {
  union {
    struct {
      uint32_t CHAN       : 24;  /**< Disable byte swap */
      uint32_t reserved24 :  8;
    };
    uint32_t VALUE32;
  };
} ADI_DMA_BS_CLR_t;
#endif /* !__ADI_NO_DECL_STRUCT_ADI_DMA_BS_CLR_t__ */

/*@}*/

/** @defgroup SRCADDR_SET DMA channel source address decrement enable set (SRCADDR_SET) Register
 *  DMA channel source address decrement enable set (SRCADDR_SET) Register.
 *  @{
 */

/* ==========================================================================
 *! \struct ADI_DMA_SRCADDR_SET_Struct
 *! \brief  DMA channel source address decrement enable set Register bit field structure
 * ========================================================================== */
#ifndef __ADI_NO_DECL_STRUCT_ADI_DMA_SRCADDR_SET_t__
typedef struct _ADI_DMA_SRCADDR_SET_t {
  union {
    struct {
      uint32_t CHAN       : 24;  /**< Source Address decrement status / configure Source address decrement */
      uint32_t reserved24 :  8;
    };
    uint32_t VALUE32;
  };
} ADI_DMA_SRCADDR_SET_t;
#endif /* !__ADI_NO_DECL_STRUCT_ADI_DMA_SRCADDR_SET_t__ */

/*@}*/

/** @defgroup SRCADDR_CLR DMA channel source address decrement enable clear (SRCADDR_CLR) Register
 *  DMA channel source address decrement enable clear (SRCADDR_CLR) Register.
 *  @{
 */

/* ==========================================================================
 *! \struct ADI_DMA_SRCADDR_CLR_Struct
 *! \brief  DMA channel source address decrement enable clear Register bit field structure
 * ========================================================================== */
#ifndef __ADI_NO_DECL_STRUCT_ADI_DMA_SRCADDR_CLR_t__
typedef struct _ADI_DMA_SRCADDR_CLR_t {
  union {
    struct {
      uint32_t CHAN       : 24;  /**< Disable source address decrement */
      uint32_t reserved24 :  8;
    };
    uint32_t VALUE32;
  };
} ADI_DMA_SRCADDR_CLR_t;
#endif /* !__ADI_NO_DECL_STRUCT_ADI_DMA_SRCADDR_CLR_t__ */

/*@}*/

/** @defgroup DSTADDR_SET DMA channel destination address decrement enable set (DSTADDR_SET) Register
 *  DMA channel destination address decrement enable set (DSTADDR_SET) Register.
 *  @{
 */

/* ==========================================================================
 *! \struct ADI_DMA_DSTADDR_SET_Struct
 *! \brief  DMA channel destination address decrement enable set Register bit field structure
 * ========================================================================== */
#ifndef __ADI_NO_DECL_STRUCT_ADI_DMA_DSTADDR_SET_t__
typedef struct _ADI_DMA_DSTADDR_SET_t {
  union {
    struct {
      uint32_t CHAN       : 24;  /**< Destination Address decrement status / configure destination address decrement */
      uint32_t reserved24 :  8;
    };
    uint32_t VALUE32;
  };
} ADI_DMA_DSTADDR_SET_t;
#endif /* !__ADI_NO_DECL_STRUCT_ADI_DMA_DSTADDR_SET_t__ */

/*@}*/

/** @defgroup DSTADDR_CLR DMA channel destination address decrement enable clear (DSTADDR_CLR) Register
 *  DMA channel destination address decrement enable clear (DSTADDR_CLR) Register.
 *  @{
 */

/* ==========================================================================
 *! \struct ADI_DMA_DSTADDR_CLR_Struct
 *! \brief  DMA channel destination address decrement enable clear Register bit field structure
 * ========================================================================== */
#ifndef __ADI_NO_DECL_STRUCT_ADI_DMA_DSTADDR_CLR_t__
typedef struct _ADI_DMA_DSTADDR_CLR_t {
  union {
    struct {
      uint32_t CHAN       : 24;  /**< Disable destination address decrement */
      uint32_t reserved24 :  8;
    };
    uint32_t VALUE32;
  };
} ADI_DMA_DSTADDR_CLR_t;
#endif /* !__ADI_NO_DECL_STRUCT_ADI_DMA_DSTADDR_CLR_t__ */

/*@}*/

/** @defgroup REVID DMA Controller Revision ID (REVID) Register
 *  DMA Controller Revision ID (REVID) Register.
 *  @{
 */

/* ==========================================================================
 *! \struct ADI_DMA_REVID_Struct
 *! \brief  DMA Controller Revision ID Register bit field structure
 * ========================================================================== */
#ifndef __ADI_NO_DECL_STRUCT_ADI_DMA_REVID_t__
typedef struct _ADI_DMA_REVID_t {
  union {
    struct {
      uint32_t VALUE      :  8;  /**< DMA Controller revision ID */
      uint32_t reserved8  : 24;
    };
    uint32_t VALUE32;
  };
} ADI_DMA_REVID_t;
#endif /* !__ADI_NO_DECL_STRUCT_ADI_DMA_REVID_t__ */

/*@}*/

/** @defgroup STAT Status (STAT) Register
 *  Status (STAT) Register.
 *  @{
 */

/* ==========================================================================
 *! \struct ADI_FLCC_STAT_Struct
 *! \brief  Status Register bit field structure
 * ========================================================================== */
#ifndef __ADI_NO_DECL_STRUCT_ADI_FLCC_STAT_t__
typedef struct _ADI_FLCC_STAT_t {
  union {
    struct {
      uint32_t CMDBUSY    :  1;  /**< Command busy */
      uint32_t WRCLOSE    :  1;  /**< WRITE registers are closed */
      uint32_t CMDCOMP    :  1;  /**< Command complete */
      uint32_t WRALCOMP   :  1;  /**< Write almost complete */
      uint32_t CMDFAIL    :  2;  /**< Provides information on command failures */
      uint32_t SLEEPING   :  1;  /**< Flash array is in low power (sleep) mode */
      uint32_t ECCERRCMD  :  2;  /**< ECC errors detected during user issued SIGN command */
      uint32_t ECCRDERR   :  2;  /**< ECC IRQ cause */
      uint32_t OVERLAP    :  1;  /**< Overlapping Command */
      uint32_t reserved12 :  1;
      uint32_t SIGNERR    :  1;  /**< Signature check failure during initialization */
      uint32_t INIT       :  1;  /**< Flash controller initialization in progress */
      uint32_t ECCINFOSIGN :  2;  /**< ECC status of flash initialization */
      uint32_t ECCERRCNT   :  3;  /**< ECC correction counter */
      uint32_t reserved20  :  5;
      uint32_t ECCICODE    :  2;  /**< ICode AHB Bus Error ECC status */
      uint32_t ECCDCODE    :  2;  /**< DCode AHB Bus Error ECC status */
      uint32_t CACHESRAMPERR :  1;  /**< SRAM parity errors in Cache Controller */
      uint32_t reserved30    :  2;
    };
    uint32_t VALUE32;
  };
} ADI_FLCC_STAT_t;
#endif /* !__ADI_NO_DECL_STRUCT_ADI_FLCC_STAT_t__ */

/*@}*/

/** @defgroup IEN Interrupt Enable (IEN) Register
 *  Interrupt Enable (IEN) Register.
 *  @{
 */
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
