jobitjoseph/Acestat-Wireless/ACEstat_Firmware/aducm355-examples/examples/ApplicationExamples/M355_RadiatedImmunity_Demo/AD5940Main.c

/******************************************************************************
Copyright (c) 2017-2019 Analog Devices, Inc. All Rights Reserved.

This software is proprietary to Analog Devices, Inc. and its licensors.
By using this software you agree to the terms of the associated
Analog Devices Software License Agreement.

*****************************************************************************/

#include "ad5940.h"
#include "AD5940.h"
#include <stdio.h>
#include "string.h"
#include "math.h"
#include "RadiatedImmunity_Demo.h"
#include "M355_EMCFlash.h"
#include "PwrLib.h"

#define APPBUFF_SIZE 1000
uint32_t AppBuff[APPBUFF_SIZE];
float LFOSCFreq;

#define CO_uA_Per_PPM   80e-3

uint8_t ucUseArray1 = 0;
uint16_t uiSramCnt = 0;
uint16_t szSamplesinSRAM1[128];           // Array to store shifted ADC measurements for current channel - when full, moved to flash
uint16_t szSamplesinSRAM0[128];           // Array to store shifted ADC measurements for current channel - when full, moved to flash
int16_t ucPage = 0;

unsigned char ucTxBufferEmpty  = 0;	           // Used to indicate that the UART Tx buffer is empty
unsigned char szTemp[64] = "";		           // Used to build string before printing to UART

/* Print data to Uart and also store in Flash */
int32_t AMPShowResult(float *pData, uint32_t DataCount)
{
  AppAMPCfg_Type *pAmpCfg;
  AppAMPGetCfg(&pAmpCfg); 
  float Current_uA = 0.0;
  for(int i=0;i<DataCount;i++)
  {
    Current_uA = AppAMPCalcCurrent(pAmpCfg->SensorCh0.ResultBuffer[i], pAmpCfg->SensorCh0.RtiaCalValue.Magnitude);
    printf("Index %i:, %d , %.3f uA , %f ppm\n", i, pAmpCfg->SensorCh0.ResultBuffer[i], Current_uA, Current_uA/CO_uA_Per_PPM);
    
    if ((ucUseArray1 %2) == 1)
    {
      szSamplesinSRAM1[uiSramCnt++] = pAmpCfg->SensorCh0.ResultBuffer[i];
    }
    else
    {
      szSamplesinSRAM0[uiSramCnt++] = pAmpCfg->SensorCh0.ResultBuffer[i]; 
    }
    if (uiSramCnt >= 128)
    {
      uiSramCnt = 0;
      ucUseArray1++;
      BackUpToFlash();
    }
  }
  return 0;
}
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
